mzy2364/MC_GD32/Software/Motor_Control_GD32_Bootloader/README.md

# Motor_Control_GD32_Bootloader

用于GD32电机控制器的bootloader，基于YMODEM协议
