mzy2364/MC_GD32/Software/Application/05_Oneshunt/3_OneShunt_SMO/README.md

# Motor_Control_GD32_ADC_OneShunt_SMO

基于 Motor_Control_GD32 电机开发板的单电阻 FOC 工程
