mzy2364/MC_GD32/Software/Example/12_RS485/README.txt

本例程演示RS485的通讯
需要在5P用户接口插上485扩展板
485波特率9600，定时发送数据，收到数据后会发送收到的数据
