mzy2364/MC_GD32/Software/Application/10_lvgl/04_lvgl_foc/README.md

# 04_lvgl_foc

lvgl foc 综合例程

## 使用说明

上电电机默认运行, 切换到设置界面后电机停止

在主界面短按编码器按钮控制电机起停, 当控制器进入 FAULT 模式后, 短按编码器按钮清除故障

在主界面旋转编码器设置电机的目标转速

在主界面长按编码器按钮切换至设置界面

在设置界面旋转编码器按钮选择设置项, 选择对应的设置项后短按编码器按钮进入单项设置界面

在单项设置界面旋转编码器改变设置参数, 短按编码器按钮切换设置参数的增量

在单项设计界面长按编码器按钮保存并退出设置界面

在设置界面长按编码器按钮切换至监控界面

## 设置界面参数含义

| 参数名 | 单位 | 含义 |
| --- | ---- | --- |
| RES(mR)  | mR | 电机电阻 |
| IND(uH)  | uH | 电机电感 |
| BEMF(mV) | mv | 电机反电动势 |
| POLE | 无 | 电机极对数 |
| RateRPM  | RPM  | 额定转速 |
| OLAMP | 0.1A | 开环电流 |
| OL_LockT | 0.1s | 开环转子锁定时间 |
| OL_RampT | 0.1s | 开环转速爬升时间 |
| OL_HoldT | 0.1s | 开环结束后保持时间 |
| OL_SPD | RPM  | 开环结束转速 |
| SENSOR | 无 | 传感器(0-无感 1-HALL) |
