mzy2364/MC_GD32/FOC参考文档/电机控制标幺化.pdf

986461300@qq.com（原创文档，请勿以任何形式外传；更多资料，搜索闲鱼@人间惆怅客 x）

1 / 17

求道电机控制出品，保留所有版权

# 电机控制标幺化处理解析

李若尘，子渊先生

2 / 17

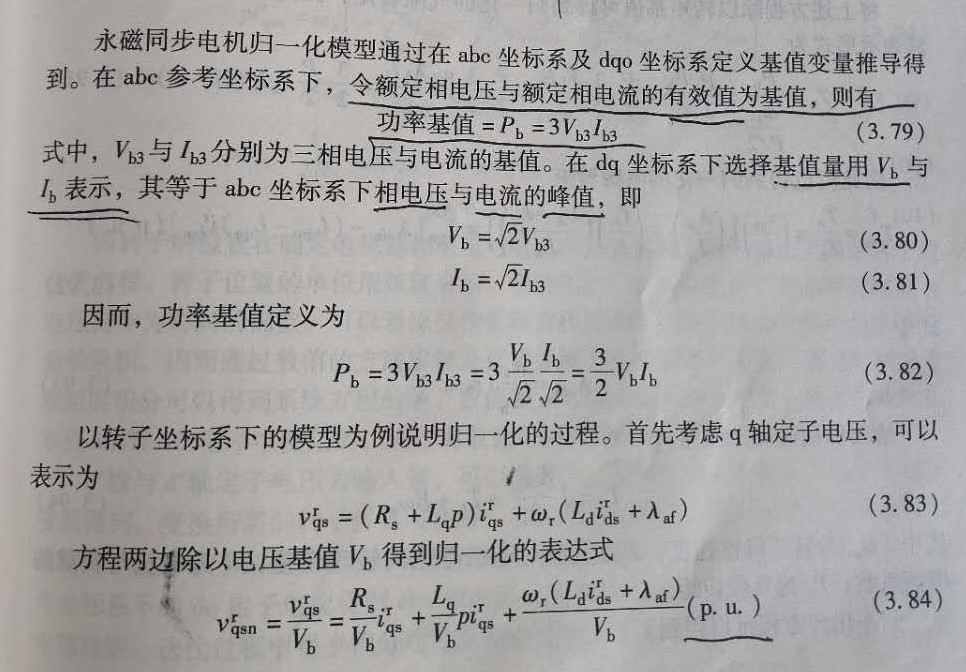
[picture p9: figure]

3 / 17

## 1 电机模型标幺化

4 / 17

### 1.1 电压方程标幺化

将控制系统的参数标幺化可降低运算过程中数据溢出的几率，同时也增加了数据运算的精度。选电压、电 流、频率作为基本基值，则有

/ | 2
/ | /
2
b | b | b | b | b | b
b | b | b | b | b | b | b
b | b
U | Z | U I | W | f
I | L | Z W | | U W
f | | | | π
| | | ψ
| θ | π
ì | | | ì = | =
ï | ï í | í Þ | = | =
ï | ï î | î =

1.1-1

将电机模型等式两边同时除以电压基值 Ub

1/

1

1 | ( | ) ( | )

b

d | s d | d | e | q q d
d d | s d | d | e | q q | U
b | b | b | b
q | q | s q | q | e | d d | r
q | s q | q | e | d d | r | q
b | b | b | b
u | R i | di | w L i di u | R i | L | w L i | L
dt | U | U | dt U | U
di | u | R i | di | w L i u | R i | L | w L i | L
dt | U | U | dt U | U

ψ
ψ

ì ì
= | + | − | ï | = | + | − ï
ï | ï í | í Þ
ï | ï | +
= | + | + | + | = | + | + ï | ï î | î

1.1-2

将式 1.1-1 带入式 1.1-2 可分别得到 d 轴 q 轴标幺化模型

/
1 | ( / ) | ( / ) | ( / )
s d | s b | d | s | d | s | d
b | b | b | b | b | b | b | b
d | d b | d | b | d | d | b | d | d | b
d
b | b | b | b | b
e | q q | e | q q | e | q q b b b
b | b | b b b | b b b
R i | R I i | R | i | R i
U | U I | U I I | Z I
di | L I d i | I | L d i | I | L | d i | I
L
dt U | U | dt | Z | dt | L W | dt
w L i | w L i | w L i W L I
U | U | W L I | W L I

ì
ï | = | = | =
ï
ï
ï
í | = | = | =
ï
ï
ï | = | = ïî

1.1-3

1 | ( / ) | ( / ) | ( / )
( | )
s q | q | q s b | s
b | b | b | b | b
q | q b | q | b | q | q | b | q | q | b
q
b | b | b | b | b
e | d d | r | b b b | e | d d | e | r | e | d d | e | r
b | b | b b b | b | b | b b b | b | b
R i | i | i R I | R
U | U I | Z I
di | L I d i | I | L d i | I | L | d i | I
L
dt U | U | dt | Z | dt | L W | dt
w L i | W L I w L i | w | w L i | w
U | U | W L I | W | W L I | W
ψ | ψ | ψ
| | | ψ | | | | ψ

ì
ï | = | =
ï
ï
ï
í | = | = | =
ï
ï | +
ï | = | + | = | +
ïî

1.1-4

( / )

( / )

d | s | d | d | d | b | e | q q
b | b | b | b | b | b b b
q | q | q | q | b s | e | d d | e | r
b | b | b | b | b | b b b | b | b
u | R i | L | d i | I | w L i
U | Z I | L W | dt | W L I
u | i | L | d i | I R | w L i | w
U | Z I | L W | dt | W L I | W

ψ
ψ

ì
ï | = | + | −
ï
í
ï
= | + | + | + ï
î

1.1-5

以标幺化的变量表示，那么有

*
* | * * | * | * * *

*
* | * * | * | * * * | * | *

1

1

d
d | s d | d | e | q q
b

q
q | s q | q | e | d d | e | r
b

di
u | R i | L | w L i
W | dt

di
u | R i | L | w L i | w
W | dt

ψ

ì
ï = | + | −
ï
í
ï
= | + | + | + ï
î

1.1-6

5 / 17

### 1.2 采样时间标幺化

式 1.1-6 可化为

*
*
* | * * | * | * * * | | | * | * * | * | * * *

*

* | *
* | * * | * | * * * | * | * | * | * * | * | * * * | * | *
*
/ (1/ | )
/ (1/ | )

d
d
d | s d | d | e q q | | | d | s d | d | e q q
b
q | q
q | s q | q | e d d | e | r | q | s q | q | e d d | e | r
b
di | di u | R i | L | w L i | u | R i | L | w L i dt | W | dt
di | | | | | | | | | | di
u | R i | L | w L i | w | u | R i | L | w L i | w
dt | W | dt
ψ | ψ
ì | ì
ï = | + | − | ï = | + | − ï | ï í | í Þ
ï | ï = | + | + | + | = | + | + | + ï | ïî î

1.2-1

对比可知时间可以 1/(2*pi*fb)为基值进行标幺化。完全标幺化之后，标幺模型和有名值模型在形式上可以 做到统一

*
* | * * | * | * * *
*

*
* | * * | * | * | * * | *
*
( | ) | ( | )
d | d
d | s d | d | e | q q | d | s d | d | e q q
q | q
q | s q | q | e | d d | r | q | s q | q | e | d d | r
di | di
u | R i | L | w L i | u | R i | L | w L i
dt | dt
di | di
u | R i | L | w L i | u | R i | L | w L i
dt | dt ψ | ψ
ì | | | | | | | | | | ì
ï = | + | − | = | + | − ï
ï | ï í | í Û
ï | ï = | + | + | + | = | + | + | + ï | ï î | î

1.2-2

那这意味着观测器本身相关的代码都不用改，只改变电机参数、系数以及电流电压等变量即可。在实际工 程中因为两套参数范围不太一样，故采用 Q 格式定点格式数据的时候代码并不能复用。 以下讨论基于标幺值模型，变量不再以‘*’区分。由式 1.4-8 可得微分方程

1
( | )

1
( | ( | ))

d
d | s d | e | q q
d

q
q | s q | e | d d | r
q

di
u | R i | w L i
dt | L
di
u | R i | w L i
dt | L

ψ

ì
= | − | + ï
ï
í
ï | = | − | − | + ï
î

1.2-3

令 dt 为采样周期 Ts，则每一拍的电流增量为

( | )
( | ( | ))

s
d | d | s d | e | q q
d

s
q | q | s q | e | d d | r
q

T
di | u | R i | w L i
L
T
di | u | R i | w L i
L

ψ

ì
= | − | + ï
ï
í
ï | = | − | − | + ï
î

1.2-4

6 / 17

### 1.3 磁链的峰值和有效值

电机模型具有统一的形式

*
* | * * | * | * * *
*

*
* | * * | * | * | * * | *
*
( | ) | ( | )
d | d
d | s d | d | e | q q | d | s d | d | e | q q
q | q
q | s q | q | e | d d | r | q | s q | q | e | d d | r
di | di
u | R i | L | w L i | u | R i | L | w L i
dt | dt
di | di
u | R i | L | w L i | u | R i | L | w L i
dt | dt ψ | ψ
ì | | | | | | | | | | ì
ï = | + | − | = | + | − ï
ï | ï í | í Û
ï | ï = | + | + | + | = | + | + | + ï | ï î | î

1.3-1

标幺模型中电机参数 R、Ld、Lq、phi 使用标幺值，相应的输入电压、电流和角速度也使用标幺值，整个 系统使用同一套基值。相应的，如果参数都取有名值，那么就是使用有名值模型。
Y 型接法电机线电流和相电流是一样的，但是线电压和相电压则相差一个 sqrt(3)。很明显，在 dq 系模型 中 udq 都是指相电压，在实现电机模型的时候一定要使用‘相值’。电流环中输出电压 ud 和 uq 具有线值的 含义，因此在实现有名值模型的时候要除以 sqrt(3)转换成相值。
本来在 dq 系中电压和电流稳定时都是直流量，没有峰值和有效值的概念。但是由于电压和电流都是由 alpha-beta 系中正弦量转换而来的，取决于克拉克变换系数，常令 dq 系中矢量幅值等于 alpha-beta 系中电信号 的峰值或者有效值，于是 dq 系也有了区分。
从公式来看，还不是电压和电流统一使用有效值或者峰值就可以，还要考虑永磁链的处理。永磁链的计算 公式为
1 | 3
2 | 2 r | ph kV
f

ψ
π
= | × | ×
1.3-2

K 值取 2/3 或者 sqrt(2)/3，phi_r 的值是不一样的，实际上还是 2*pi*f*phi_r 这个反电势是取峰值还是有效 值的区别。K = sqrt(2)/3 时，phi_r 取的是‘有效值’。

7 / 17

### 1.4 汇川对应代码

### 1.4.1 电阻标幺

取电机额定电压对应相值作为电压基值，以电机额定电流（线值和相值一样）作为电流基值，电机定子电 阻标幺化处理如下
m_UData = ((Ulong)gMotorExtInfo.RsPm * (Ulong)gMotorInfo.Current)/gMotorInfo.Votage; gMotorExtPer.Rpm = ((Ulong)m_UData * 18597)>>14;
代码中电阻单位为毫欧、电流单位为 0.01A、电压单位为 1V，故
14 | 14
18597 | . | 18597 | 1000 | 100
2 | . | 2 | 3

s

| | | b

b
pu
RsPm gMotorInfo Current | I
R
| gMotorInfoVota

R
| ge | | U
- | × | · ×
=
× | ×
× | ×
×

=
1.4-1

整理得

5
16 | 16
14 | /
18597 10 | 2
2 | 3 | /

2

s | s
spu
b b

u
b

p
b
R | R
R
U

R
I | I U

×
= | = | · | = | ×
×
- 1.4-2

电机标幺值具有 Q16 格式，因为一般情况下 Un/In 还是比定子电阻大很多，所以不用考虑溢出的问题。比 如电机 Rs = 1.500、Un = 17、In = 1.50。

8 / 17

### 1.4.2 电感标幺

m_BaseL = ((Ulong)gMotorInfo.Votage * 3678)/gMotorInfo.Current; m_BaseL = ((Ulong)m_BaseL * 5000)/gBasePar.FullFreq01;//Q15 m_Ulong = ((Ulong)gMotorExtInfo.LD <<14) + (m_BaseL >>1); m_Ulong = m_Ulong / m_BaseL;
gMotorExtPer.LD = m_Ulong / 10; // 同步机 d 轴电感 Q13 首先求电感基值
3678 5000 | . | 3678 5000 | 3
_ | =
. | 01 | . | 100 | 100 b
b | b
gMotorInfoVotage | U
m BaseL
gBasePar FullFreq | gMotorInfo Current | f | I
× | × | ×
- ·

× ×
=
| | | | × | ×

1.4-3

整理得

3678 5000 | 3 2 _ | =3678 | 3 | =3678 | 3
100 100 | 2

b

b

b
b
b | b

U
mB

Z
aseL | L
f I | W

π
π | π
π
× | × | ×
= | · | × | · | × | ·
× | ·

1.4-4

省略代码中四舍五入的处理，电感量单位为 uH，故变量 m_Ulong 满足

14 | 14 | 6 14 | 6 2 | . | 2 | 10 2 | 10 | 13 _ | = | = | 100 2
3678 | 3 | 3678 | 3 | 3678 | 3

d
dpu | d u
b

p
b
gMotorExtInfo LD | L
m Ulong | L | L
π | π | π L | L
× | × × | ×
= | = | ×
× | · | × | · | ×

1.4-5

最后除以 10

13
13 _ | 100
10 | 10
| 2
10 2

dpu
dpu

m Ulong gMotorExtPer LD

L
L

×
= | × | ×

×
= | =

1.4-6

电感经过上述代码处理之后，除了 Q13 格式外还有个系数 10，比较突兀，可能是处理有问题。直观上看 一下电感标幺，令 Un = 17、In = 1.50、fn = 220Hz、Ld = 600uH，电感标幺值数值上还是比较小的

4 0.0082
2

17
= | = | 6 10 2 | 220 1.5

0.008

0.07
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
f | L
L

L
I
H
π | π

−
·
=

ì
ï | = | ×
í | × | × | Þ | = | =
ï
î

1.4-7

9 / 17

变量 gMotorExtPer.LD 具有 Q13 格式，令 Ld、Lb 为带 SI 单位的有名值，那么有

13
. | 2 () d

b

gMotorExtPer LD

L
SI
L

= ×
1.4-8

两边同乘以 10，于是

13 | _
10 | . | 10 | 2=
_

d

b

L | m Ulong gMotorExtPer LD
L | m BaseL
× | = | × | ×
1.4-9

将变量 m_Ulong 带入式 1.4-9，并省略四舍五入的计算，那么有

13 | 14 ( | . | 14 | ( _ | 1) | . 10 | 2
_ | _

)
2 = | = d

b

gMotorExtInfo LD | m BaseL | gMotorExtInfo LD
m BaseL | m BaseL

L
L
<< | + | >>
× | × | ×
1.4-10

变量 gMotorExtPer.LD 的单位应该是 uH，于是可化为

6 | 6
1 | 14

6
3
. | /1 | 10 10 | 2 | 5
_

1
_
10 2 = | = d | 0
b | b m BaseL | m BaseL
L | gMotorExtIn | D
L

fo L
L

·
× | × | × | Þ ×

1.4-11

将 Lb 展开并整理，得

6 | 6
_
5

10 10
=
| 5 2
b | b
b | b

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
1.4-12

其中有

3
10

=

=
0
. | 01
10

=
0

b

b

b

gMotorInfoVotage

gMotorInfo Current

gBasePar FullFreq

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
1.4-13

将式 1.4-13 带入式 1.4-12 得

6
10 100 100
=
2
_
5 | . | 01 | . 3

gMotorInfoVotage m BaseL
π | gBasePar FullFreq | gMotorInfo Current ·

×
×

1.4-14

整理常数项

3678 | .
_ | =
. | 01 | .
9. | 00 99 | 50 | gMotorInfoVotage m BaseL
gBasePar FullFreq | gMotorInfo Current
× | ×
×
·

1.4-15

这里也有个 10 的系数。
于是，从正反两面进行推导，电感标幺化的结果都是理论结果的 10 倍，后续电流模型的推导可以证明这 个 10 倍的系数不应该存在。（可能是因为电感的单位是 10uH）

10 / 17

### 1.4.3 磁链标幺

在 dq 坐标系，永磁链产生的反电势为（相电压）

1.4-16

令此时三相电压信号峰峰值为 Vlpp，则相电压峰值为

/ 2 / 3 V | V ph | lpp =
1.4-17

相电压经过克氏变换，在两相静止坐标系内电压信号峰值变为

3
2
V | kV m | ph =

1.4-18

由于 park 变换不改变矢量长度，故式 1.4-18 与式 1.4-16 相等，于是

3 | 1 | 3 2
2 | 2 | 2 ph | r | r | ph kV | f | k V
f

π ψ ψ
π
= | · | Þ | = | × | ×
1.4-19

磁链基值和电压基值关系密切

2
2

b
b | b | b | b
b

U
U f
f
ψ | π ψ
π
= | Þ | = | ·
1.4-20

于是磁链的标幺化可以由反电势标幺化实现，以频率基值对应的反电势除以电压基值即可，辨识反电势时 将频率做相应的转换即可

| 2
/
| 2
b | r | r
emfb | b
b | b | b

f
V U
f
πψ | ψ
π ψ | ψ

·
| | | | | | | | | | | | | | | | = | | =
| | | | | | | | | | | | | | | | | ·

1.4-21

处理磁链标幺化的代码如下
m_Ulong = ((long)gMotorExtInfo.BemfVolt <<12) / (gMotorInfo.Votage *10); //Q12
gMotorExtPer.FluxRotor = (m_Ulong << 15) / gMotorInfo.FreqPer; | //Q12
其中变量 gMotorExtInfo.BemfVolt 为 0.1V 精度的额定频率对应的反电势线电压有效值，这个电压应该是在 对拖时可以用电压表、示波器等量得到的实实在在的线电压。
取克拉克变换系数 k= sqrt(2)/3，由式 1.4-19 可得反电势对应的线电压有效值，满足
3 | 3 | 2 | 1 | 3 2 | 3 2
2 | 2 | 3 | 2 | 2 ph | ph | ph | r | ph | r kV | V | V | f | V | f = × | = | = | · | Þ | = | × | · π ψ | π ψ

1.4-22

以电机额定电压进行标幺化

12 | 12 | 12 . | 2 | 2 | 2 _ | 10
10 | .
| | | | | | | | | | | | | | | | | | | 2
10

2
3
3 | n | r | r
| | | | | | | | | | | | | | | | | | b | | | | b

n

gEstBemf BemfVolt m Ulong
gMotorInfoVotage | U U
π | ψ | π | ψ f | f ×
= | = | ×
× | ×
× | · | = | ·
1.4-23

再由额定频率转换为频率基值

15 | 15
12 | 12 | 12
15
2 | 2 . | 2
2

2
2
/

2

2
2
n | r | r n | b
b | b | b n | b

r

f | f | f gMotorExtPer FluxRotor
gMotorInfo FreqPer | U | U | U ff
| π ψ | π ψ | π ψ
= | × | × | ×
×
= | =

1.4-24

将电压基值展开，得到 Q12 格式的磁链标幺值

2 | 2 12 | 12 | 12
2
. | 2 | 2 | 2 b | b

b

r | r
b | b | b

r

f | f gMotorExtPer FluxRotor
U | f
π ψ | π ψ | ψ
| π ψ | ψ
= | × | × | × = | =
1.4-25

值得一提的是，如此处理得到的永磁链具有‘相值’的涵义，正好和电压、电流信号一致。

2 V | f emf | r = | · πψ

11 / 17

## 2 电流 PI 控制器标幺化

12 / 17

### 2.1 理论推导

电流环 PI 控制器，其输入为电流偏差，输出为控制电压，易知其传递函数为

d | i
p
d
u | k k
i | s
= | +
Δ

2.1-1

电压和电流已经标幺化的基值了，式 2.1-1 可化为

/ | /
/ | /
d | b | b | d | b | b | b | i pu
p
d | b | b | d | b | b | pu | b
u | u u | u | u | u | u | k u
k
i | i i | i | i | i | i | i | s
| ·
= | · | = | · | = | +
Δ | · | Δ | | | Δ

2.1-2

进一步地

1
( | ) pu | b | i | b | b
p | p | i
pu | b | b | b
u | i | k | i | i k | k | k
i | u | s | u | u | s
= | + | = | +
Δ

2.1-3

经过标幺化之后，PI 参数变为

b
pu | p
b

b
ipu | i
b

i
k | k
u
i
k | k
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
2.1-4

如果 PI 控制器是规范使用自动控制原理设计的，那么 Kp 和 Ki 和电机电阻和电感参数有关，标幺化处理之 后可以电阻取其标幺值，但电感并非如此。

13 / 17

### 2.2 汇川对应代码

SVPWM 线性区输出线电压峰值为

3
2
dc v | U =α

2.2-1

调制系数 alpha 可以取到 2/sqrt(3)=1.15，对应的线电压有效值为 Udc/sqrt(2)。软件中母线电压变量单位为 0.1V，需要转换单位；最大输出电压以电机额定电压为基值进行标幺化，以 Q12/Q24 格式表示：

12

/10 / *
2

dc
max | mot

U
v | v | Q =

2.2-2

data1 = ((long)gUDC.uDCFilter | * 2316L)>>15; | // Udc/sqrt(2)/10
pm_maxout_vol = (data1<<12)/gMotorInfo.Votage;
maxu = (long)pm_maxout_vol<<12;
minu = -maxu;
电流偏差是以电机额定电流为基值的标幺值，具有 Q12 的格式；pm_integral_d 受[maxu,minu]限制，故积 分量具有 Q24 格式；计算积分增量时有(pm_error_id * pm_ki_d >> 4)，可见积分增益 ki 具有 24+4-12=16 的 格式。由计算积分增量的方式可以看出代码所实现的是并联结构 PI 控制器，同时积分增益中隐含了控制周期 参数，是上一节提到的所谓的新积分增益。
pm_error_id = pm_ref_id - gIMTQ12.M;
pm_integral_d = pm_integral_d + (pm_error_id * pm_ki_d >> 4); //Q24,28-4 pm_integral_d = __IQsat(pm_integral_d, maxu, minu);
计算比例部分，因为比例部分可以和 Q24 格式的积分部分相加，故可以认为比例增益是具有 24-12=Q12 格式的数据。
data1 = (pm_integral_d + pm_error_id * pm_kp_d)>>12; data1 = __IQsat(data1,pm_maxout_vol,-pm_maxout_vol); pm_ud = data1;
由猫不和狗比原理可知，电压 pm_ud 也是以电机额定电压（线电压）为基值的 Q12 格式数据，不带小数 点！并且 ud 本身也带有‘线值’的内涵。给 ACR 控制器的输出赋予“线电压有效值”的涵义具有现实的好处， 因为评价输出电压的大小更多的是和电机额定电压进行比较，而后者最常见的形式就是线电压有效值。从本质 上来讲，ud 和 uq 应该是 d 相和 q 相的相电压。
最后再强调一遍，当前软件中电流环 PI 控制器比例增益 Kp 为 Q12 格式数据，积分增益 Ki 是 Q16 格式的 “新”积分增益。
以浮点类型有名值实现 PI 控制，那么有
1 | 1 ( | ) k | k | p | k | i s | k | k | p v | i k | i k T | v | i | k = Δ · | + Δ · | + | − Δ | ·
− | − | 2.2-3

其中，输出 vk 是实际输出电压，delta_i 是实际的电流偏差。当对数据进行标幺化并用 Q 格式表示时，令 输出电压和电流偏差满足

24 | 24
12 | 12
2 | 2
2 | 2
k | k
pu
b | mot
k | k
pu
b | mot
v | v
v
v | v
i | i
i
i | i
= | × | = | ×
Δ | Δ Δ | = | × | = | ×

2.2-4

计算积分增量时得到的是以电机额定电压为基值的 Q24 格式表示的原始积分增量，即满足

4 | 24
12 | 28
/ 2 | 2
2 | 2 pu | pu | ipu | k | k | i s
mot | ipu
mot | mot
| k | i s

x
x | i | k | i | i k T
v | k
i | v x | i k T
Δ | ü
Δ | = Δ | · | = | × | ï | Δ | Δ · ý Þ | × | · | = | ×
ï Δ = Δ · | þ

2.2-5

可推出在标幺值系统下，积分增益满足

14 / 17

16 ( | ) | 2 mot
i u | s
mot
p | i

i
k
v
= | · | × kT

2.2-6

可以看到，除了 Q16 格式化以外，k_ipu 还隐含了电机的额定电流和额定电压。 同样地，计算比例控制量时满足

12 | 12
12 | 12
/ 2 | 2
/ 2 | 2 pu | pu | ppu | k | p
mot | pu | ppu

mot
k p

y
y | i | k | ik
v | i | k
v
y i k

ü
= Δ | · | = | × | ï | Δ·
ý Þ Δ | · | = | ×
ï = Δ · | þ

2.2-7

可推出采用标幺值时，比例增益满足

12 2
mot
pp
mot

u p

i
k
v
= | · | × k

2.2-8

综上所述，使用标幺化系统实现 PI 控制时，PI 参数也隐含地经历了标幺化，而不仅仅是执行了 Q 格式化 那么简单。

12

16

2

( | ) | 2
| mot
ppu
| mot

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
= | · | × ï
ï
í
ï | = | · | × ï
î

2.2-9

上式错误!未找到引用源。可以看作是对电阻进行了标幺化处理，处理之后就不会出现 RL 数值较大时 PI 参数数值上特别大的情况。

15 / 17

## 3 锁相环标幺化

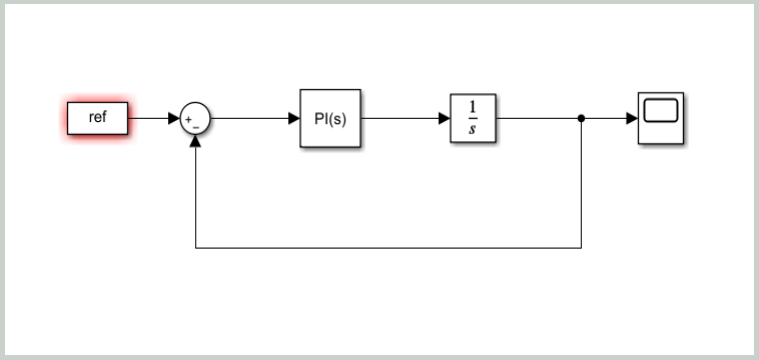
[picture p10: figure]

图 2.2-1 PLL 框图
锁相环主要由一个 PI 控制器和一个积分器构成，输出转速和角度两个量，所以标幺化需要分两个阶段进 行处理。

16 / 17

### 3.1 PI 标幺

锁相环 PI 输入为角度偏差，输出为角速度，其传递函数为

i
p
w | k
k
θ | s
= | +
Δ

3.1-1

角速度和角度标幺基值为

2 b | b

b

w | f π
θ | π

ì =
í
î =

3.1-2

于是，式 3.1-3 可化为

/ | 2 | 2
/
b | b | b | i pu | pu
b | p
b | b | pu | pu
w | w w | w | f | k w | w
f | k
s

π
θ | θ θ θ | θ | π | θ
= | · | = | · | = | · | = | +
Δ | Δ | Δ | Δ

3.1-4

进一步地

1 | 1 | 1 2
2 | 2
pu | pu i
b | p | p | i
pu | pu | b | b
w | w k
f | k | k | k
θ | θ s | f | f | s
- | = | + | Þ | = | +
Δ | Δ

3.1-5

经过标幺化之后，PI 参数变为

1
2
1
2
pu | p
b
ipu | i
b
k | k
f
k | k
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
3.1-6

也就是说，如果想要 PI 输出为标幺化的角速度，那么 PI 参数就要按照式 3.1-7 进行处理，尽管形式上看起 来十分怪异。

17 / 17

### 3.2 积分标幺

对角速度积分得到角度，其传递函数为

1
w s

θ
=

3.2-1

角速度和角度标幺基值为

2 b | b

b

w | f π
θ | π

ì =
í
î =

3.2-2

于是，式 3.2-3 可化为

/ | 1
/
b | b | b pu
w w w | w | w | s b | b | pu | b
θ θ θ | θ θ
- | = | · | =
3.2-4

进一步地

1 | 1 | 1 | 1 2
2
pu | pu b | b | b
b
pu | b | pu | b
w | f | f
w | w | s | w | s | s | s
θ | θ θ | π
θ | π
- | = Þ | = | · = | · = | ·
3.2-5

标幺化之后，积分增益由 1 变为 2*fb。
实践表明，如果不采用上述方式进行标幺化，那么锁相环 PLL 压根无法稳定，也从侧面证明了上述标幺化 处理过程的正确性。
