mzy2364/MC_GD32/PIC/MC_GD32_02.png

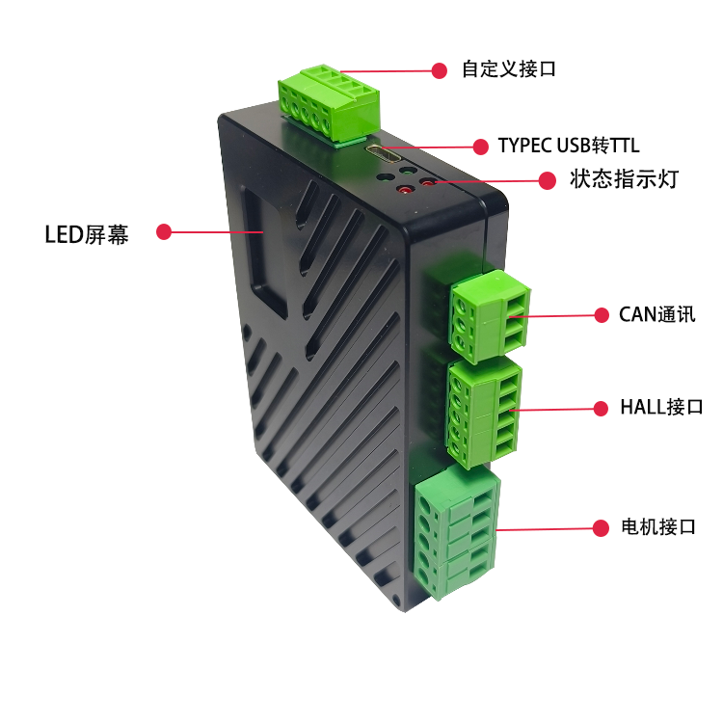
PIC/MC_GD32_02.png
