mzy2364/MC_GD32/PIC/MC_GD32_03.png

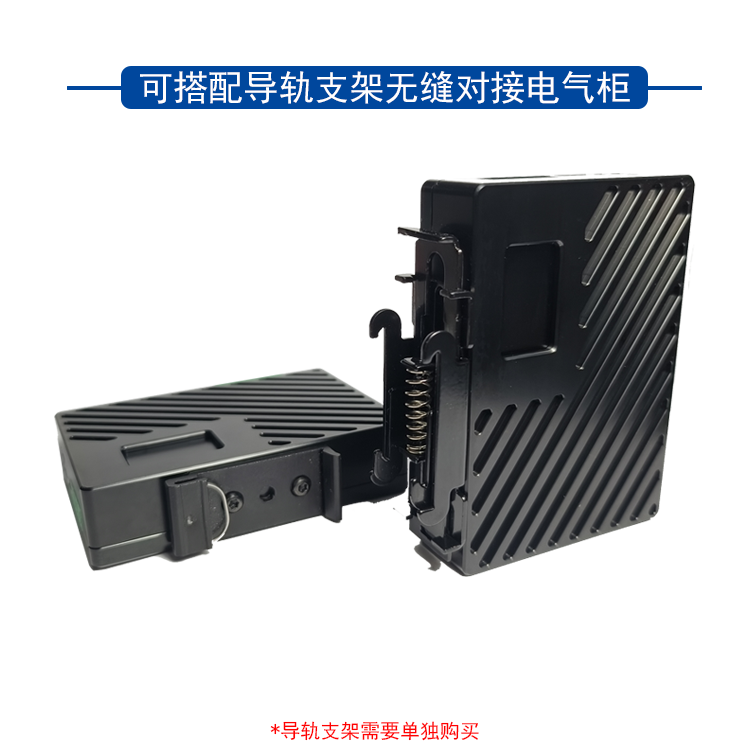
PIC/MC_GD32_03.png
