mzy2364/MC_GD32/Software/Example/9_pwmadc/RigolDS0.png

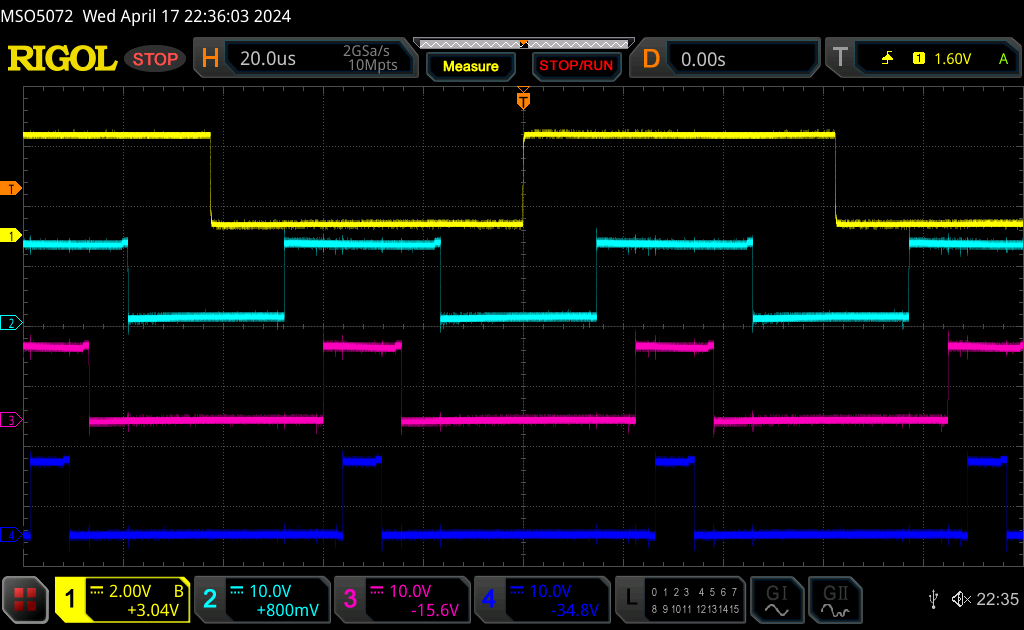
Software/Example/9_pwmadc/RigolDS0.png
