mzy2364/MC_GD32/Software/Example/8_adc/Sunlord Products Characteristic Vout max_Curcuit0_SDNT1608X103F3950FTF.xlsx

Temperature (℃) | Vout max (V) | Vout typ (V) | Vout min (V)
-40 | 3.216616633 | 3.211906695 | 3.206938431
-39 | 3.210777577 | 3.205810467 | 3.200575415
-38 | 3.204590503 | 3.199356412 | 3.193844716
-37 | 3.198039421 | 3.192528494 | 3.186730276
-36 | 3.19110798 | 3.185310348 | 3.179215745
-35 | 3.183779503 | 3.177685312 | 3.171284508
-34 | 3.176037008 | 3.169636462 | 3.162919729
-33 | 3.167863248 | 3.161146643 | 3.15410438
-32 | 3.159240747 | 3.152198516 | 3.144821296
-31 | 3.150151844 | 3.1427746 | 3.135053211
-30 | 3.140578741 | 3.132857323 | 3.124782824
-29 | 3.130503552 | 3.122429079 | 3.113992846
-28 | 3.119908365 | 3.111472285 | 3.102666065
-27 | 3.108775299 | 3.099969446 | 3.090785415
-26 | 3.097086573 | 3.087903222 | 3.078334043
-25 | 3.084824581 | 3.075256506 | 3.065295388
-24 | 3.071971961 | 3.062012499 | 3.051653256
-23 | 3.058511681 | 3.048154793 | 3.037391907
-22 | 3.044427127 | 3.033667456 | 3.022496142
-21 | 3.029702185 | 3.018535126 | 3.00695139
-20 | 3.014321343 | 3.002743101 | 2.990743806
-19 | 2.998269782 | 2.986277439 | 2.973860364
-18 | 2.981533481 | 2.969125055 | 2.956288956
-17 | 2.964099315 | 2.951273822 | 2.938018491
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
