mzy2364/MC_GD32/Software/Application/05_Oneshunt/0_TestFile/1_PWM_SHIFT/三相下管信号不移相.png

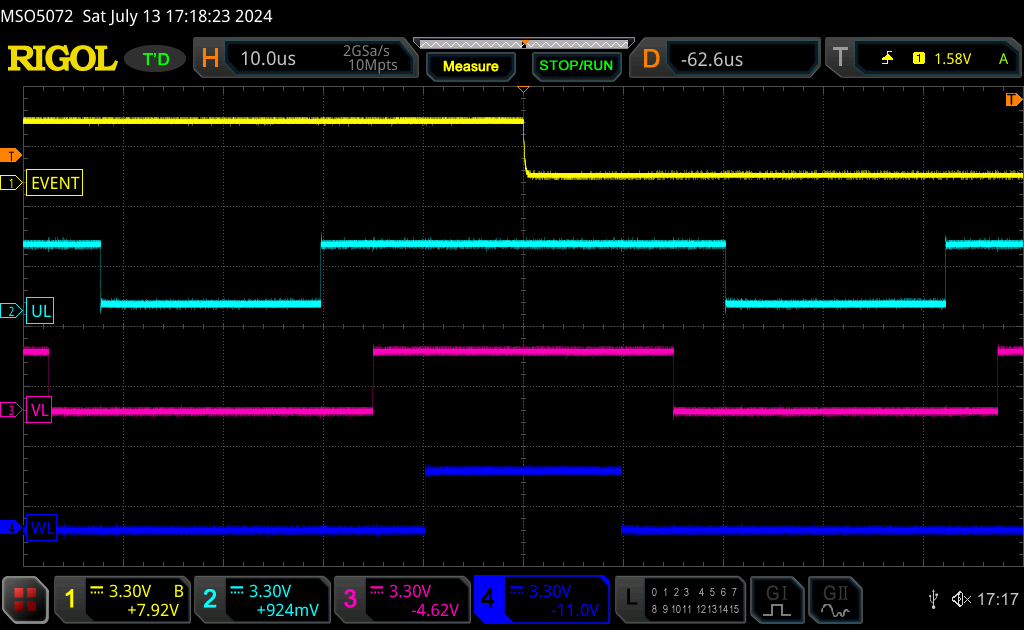
Software/Application/05_Oneshunt/0_TestFile/1_PWM_SHIFT/三相下管信号不移相.png
