mzy2364/MC_GD32/Software/Application/05_Oneshunt/0_TestFile/2_ADC_DOUBLE_SAMPLE/三相下管信号和ADC采样完成信号.png

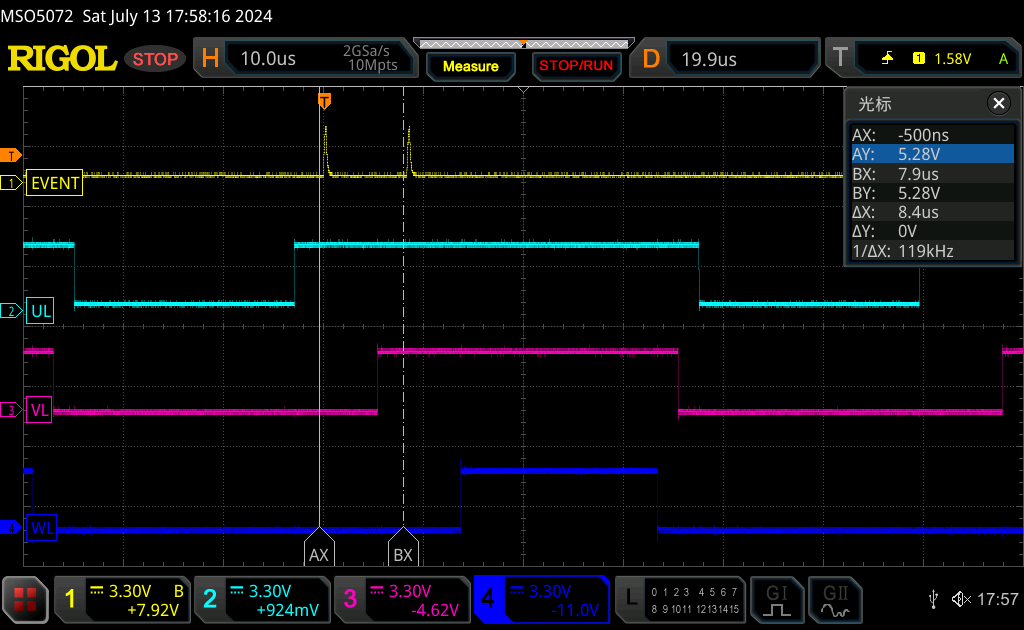
Software/Application/05_Oneshunt/0_TestFile/2_ADC_DOUBLE_SAMPLE/三相下管信号和ADC采样完成信号.png
