mzy2364/MC_GD32/Software/Application/05_Oneshunt/0_TestFile/3_OneShunt_SMO/三相下管和IDC.png

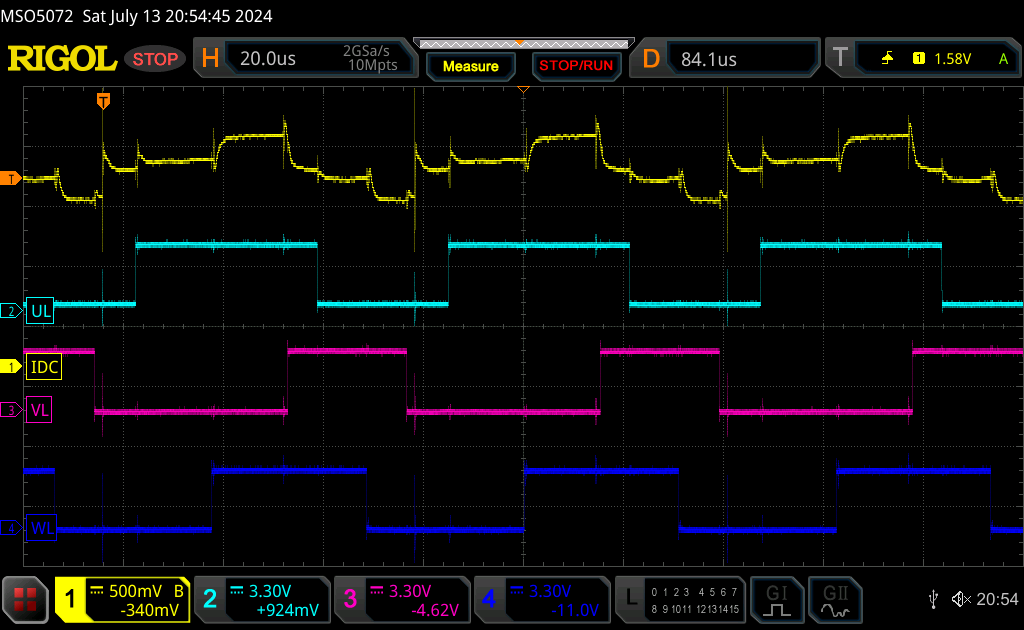
Software/Application/05_Oneshunt/0_TestFile/3_OneShunt_SMO/三相下管和IDC.png
