mzy2364/MC_GD32/Hardware/Motor_Control_GD32_V4_2.pdf

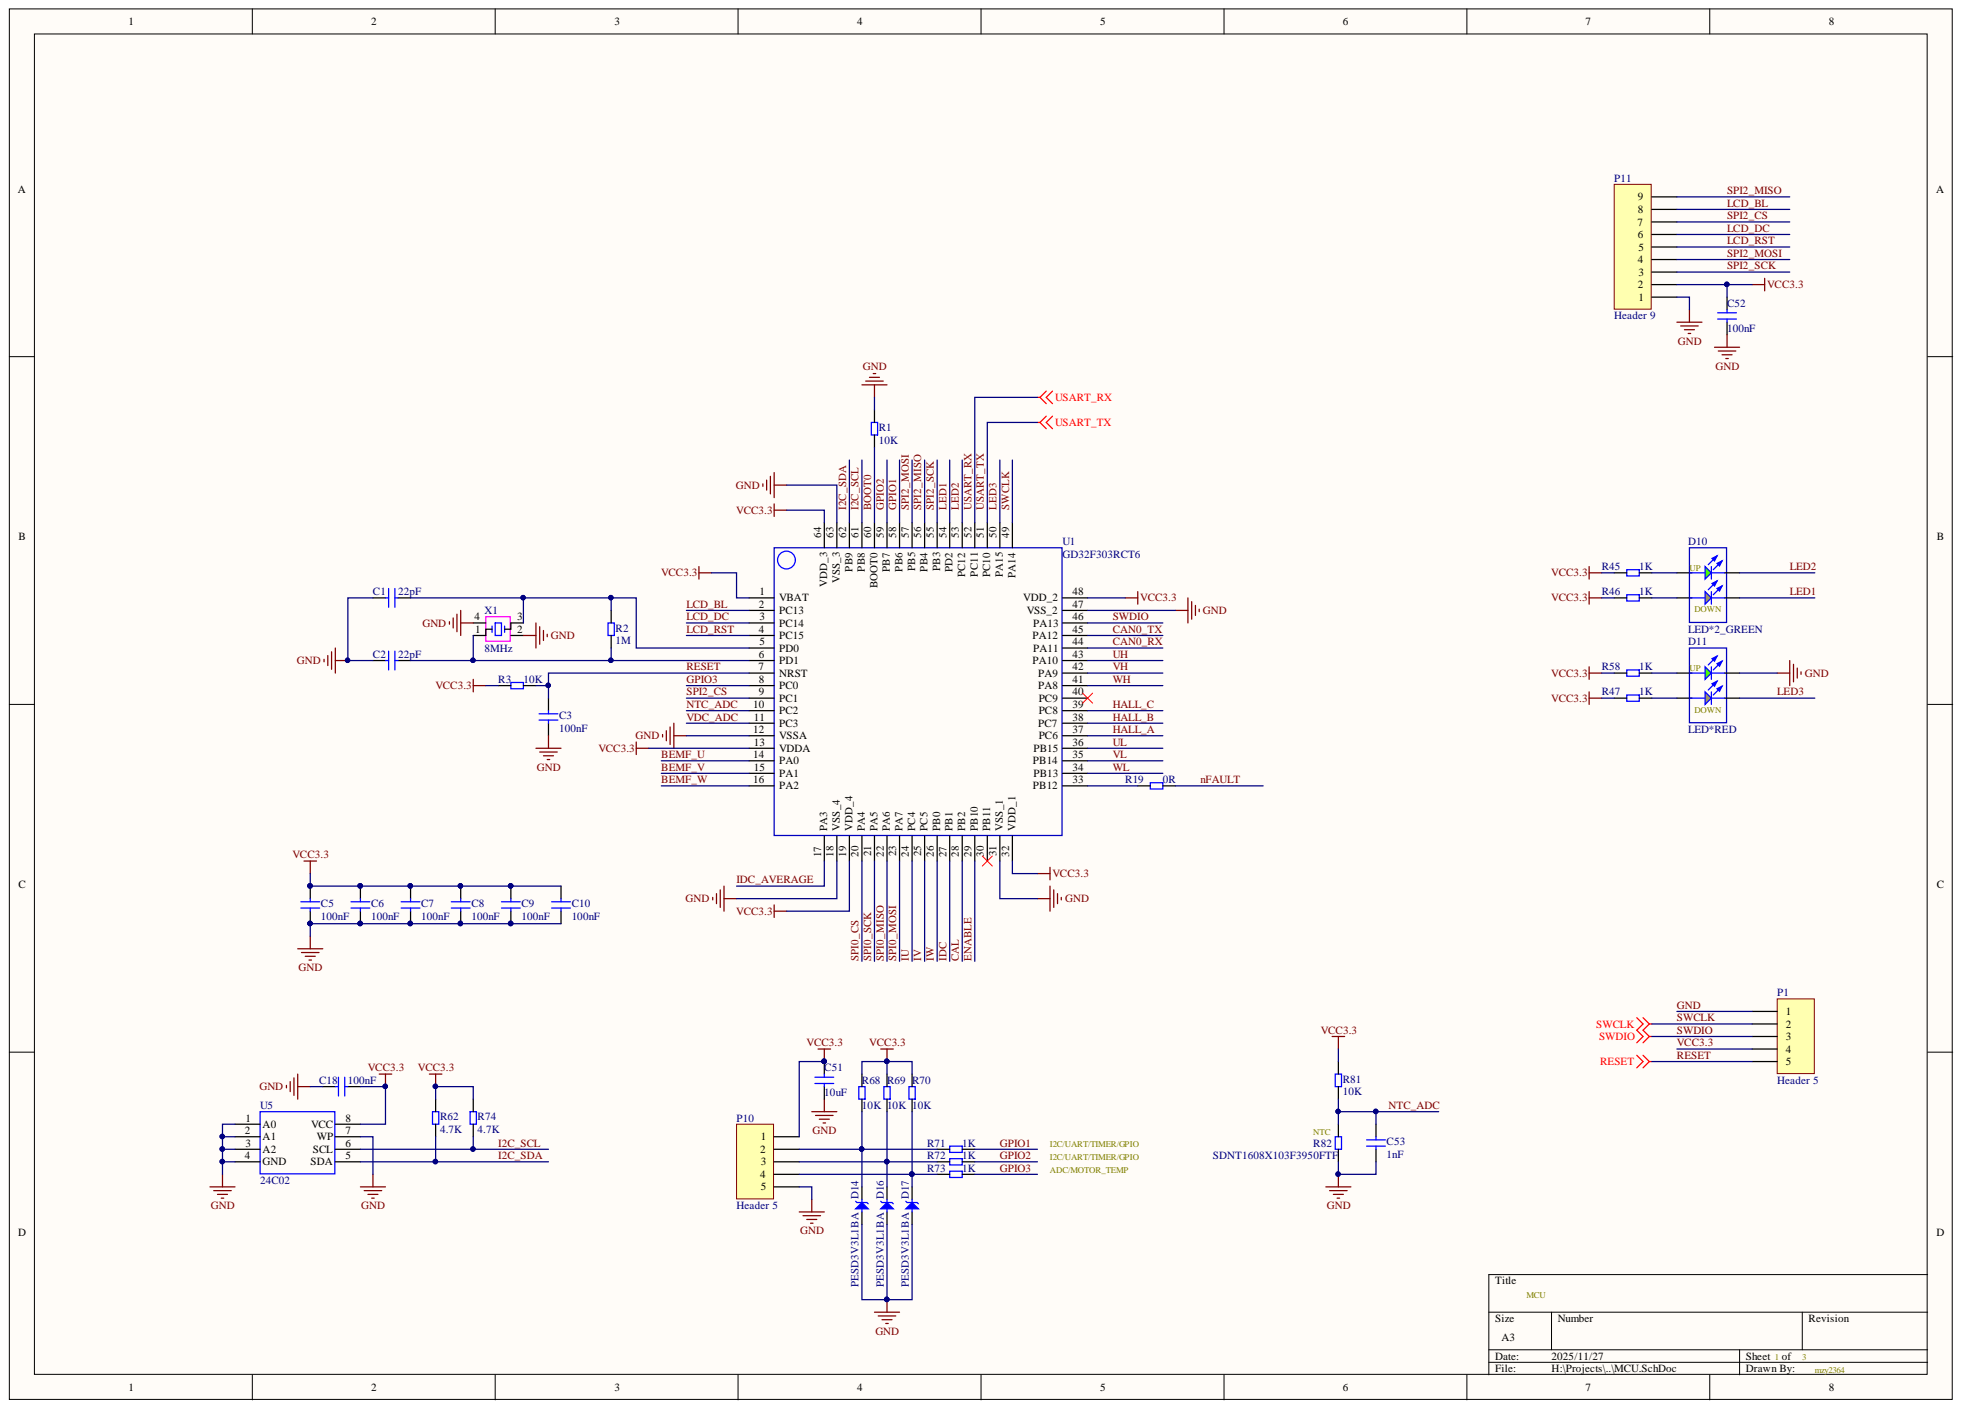
[picture p64: page 1]

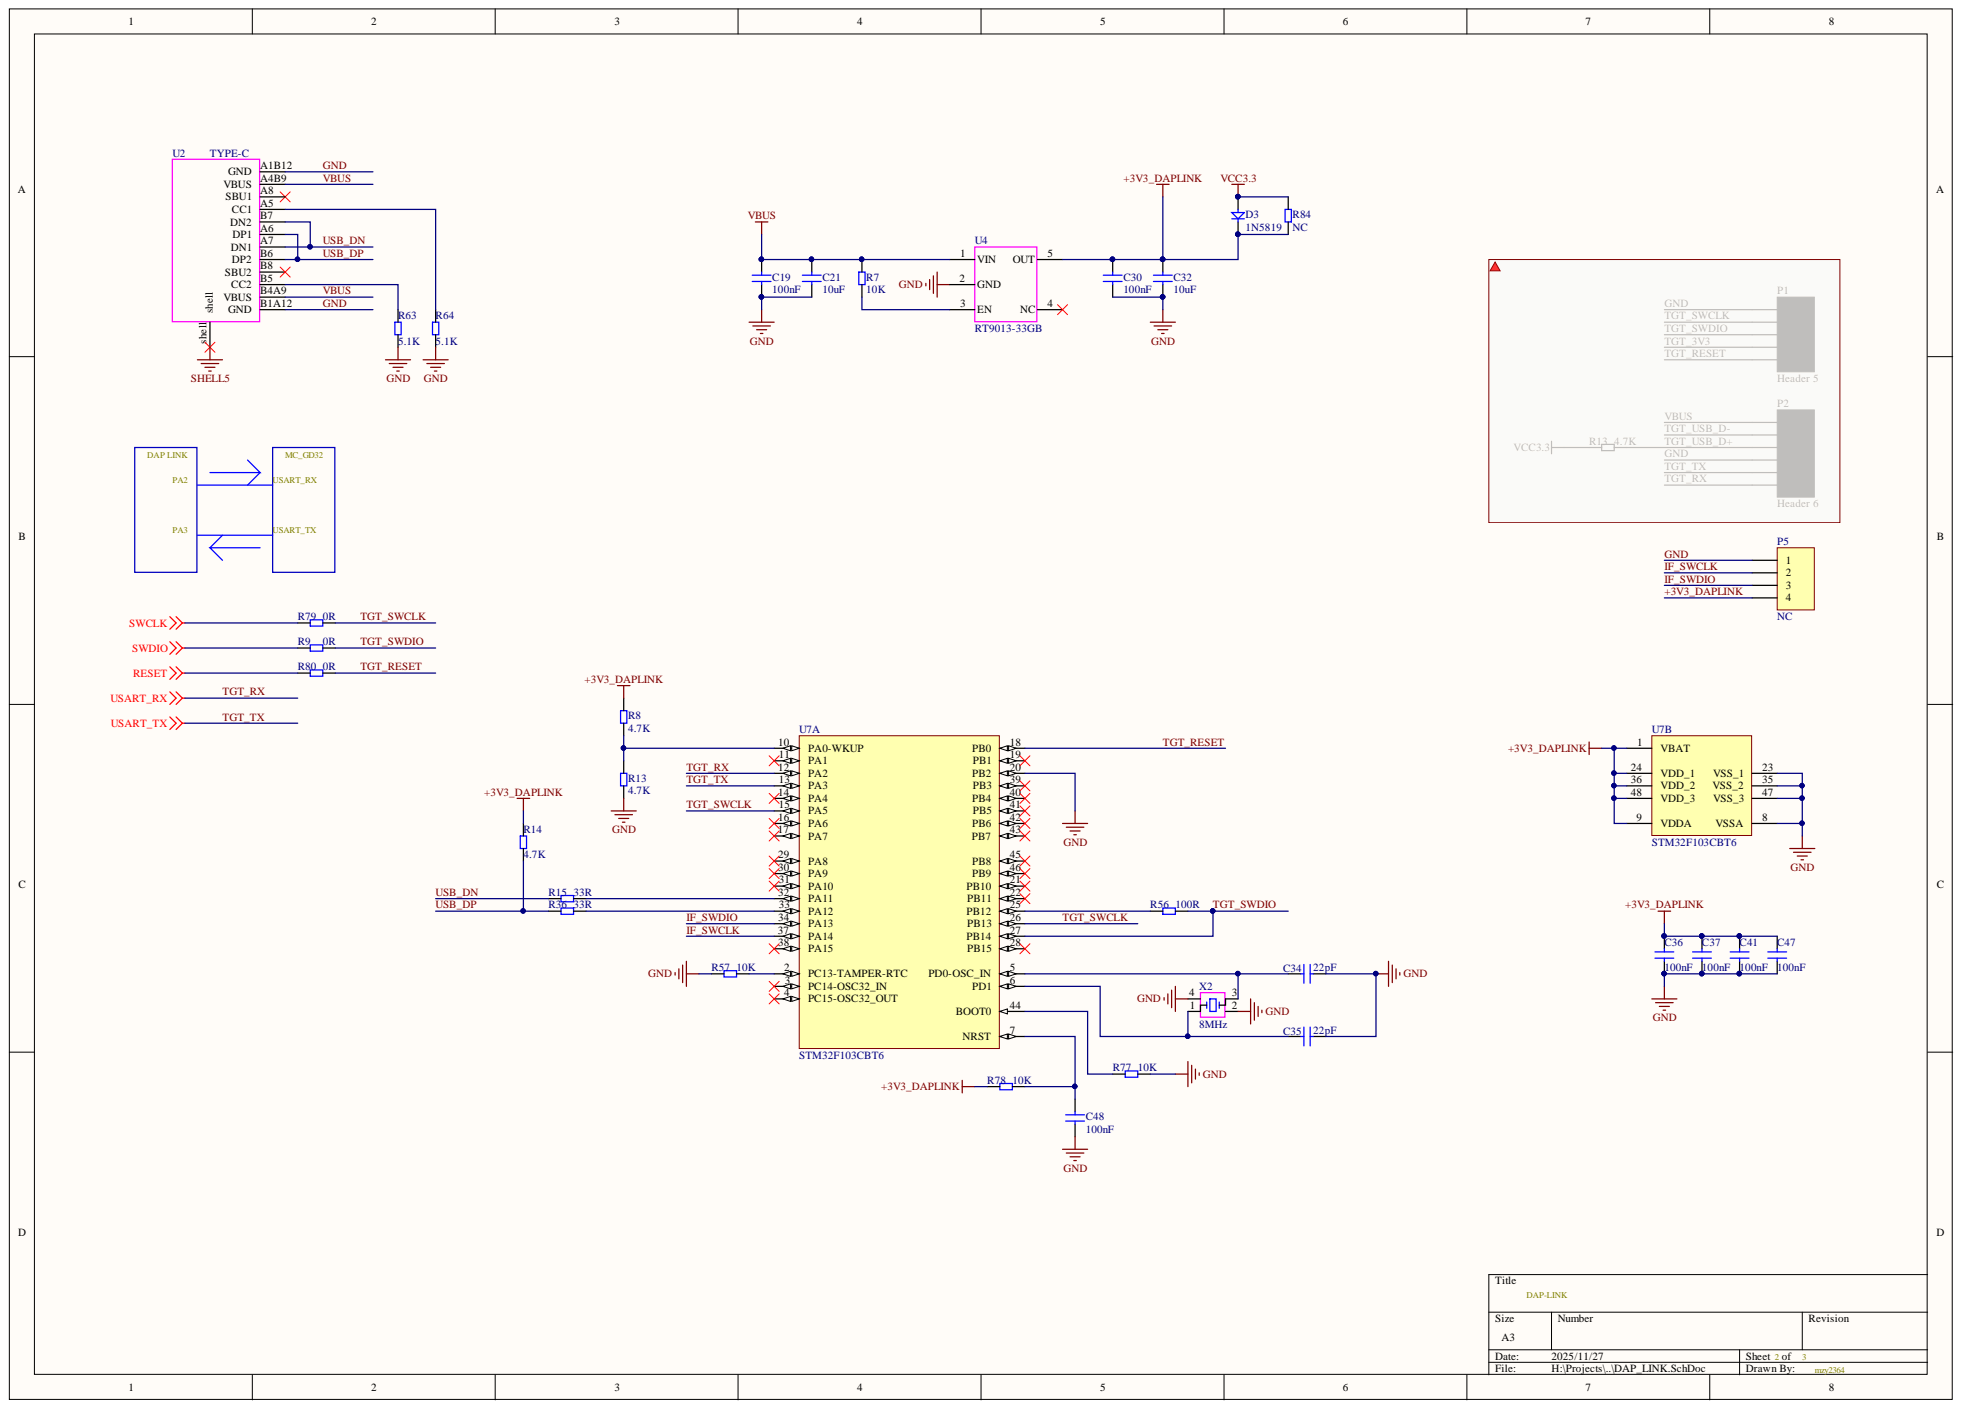
[picture p65: page 2]

GND 2 | C30 | P1

VBUS GND

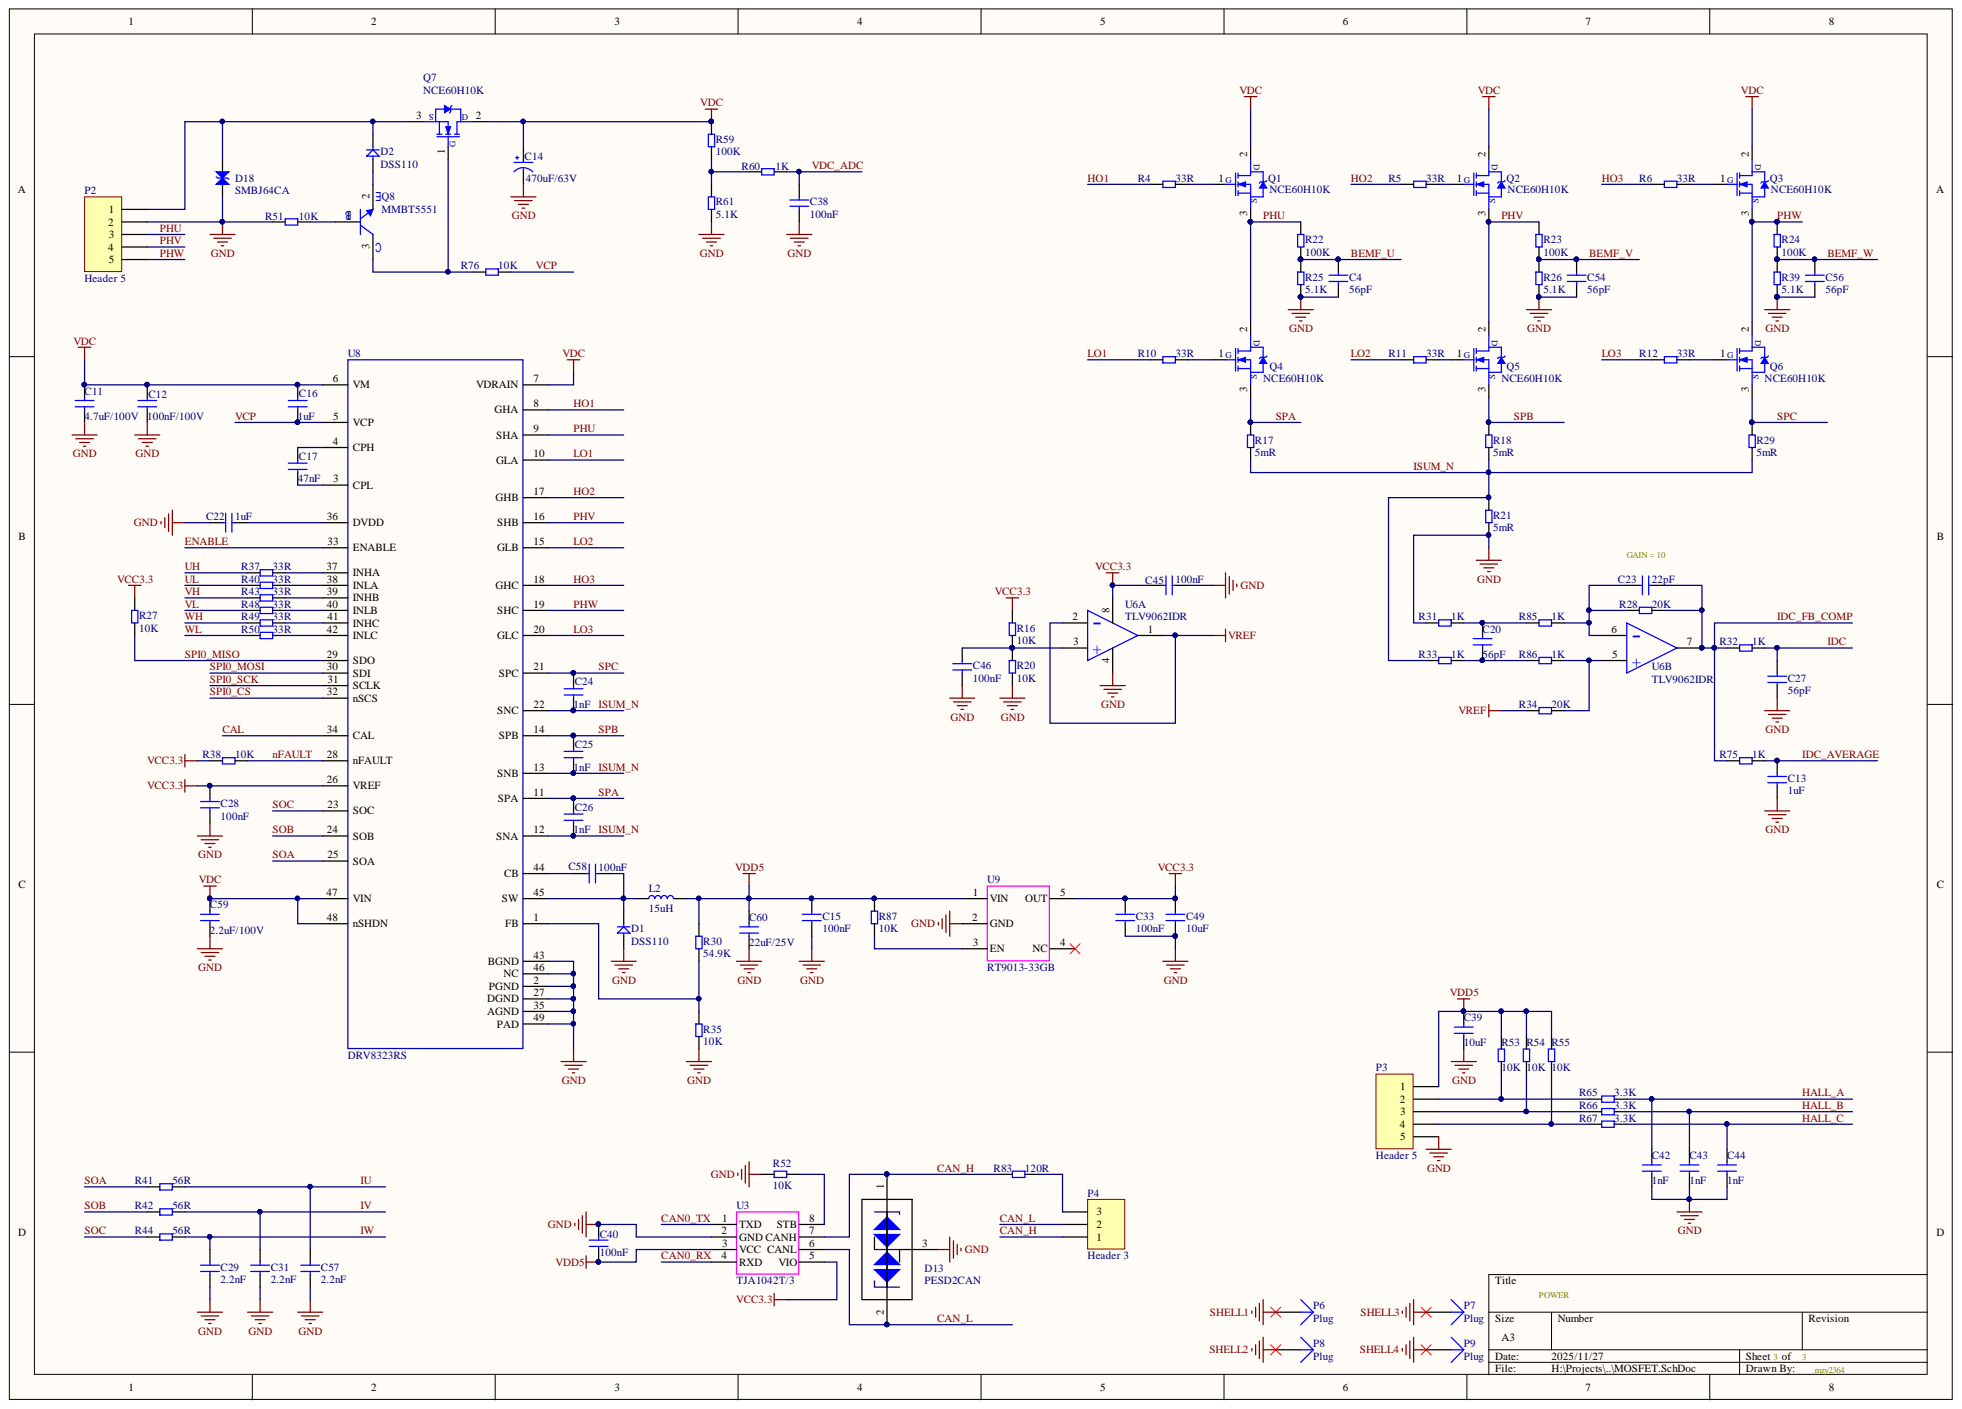
[picture p66: page 3]

nSHDN 48

VCC 3 | | 3

CAN_L
