mzy2364/MC_GD32/Hardware/Motor_Control_GD32_V4_2_Layout.pdf

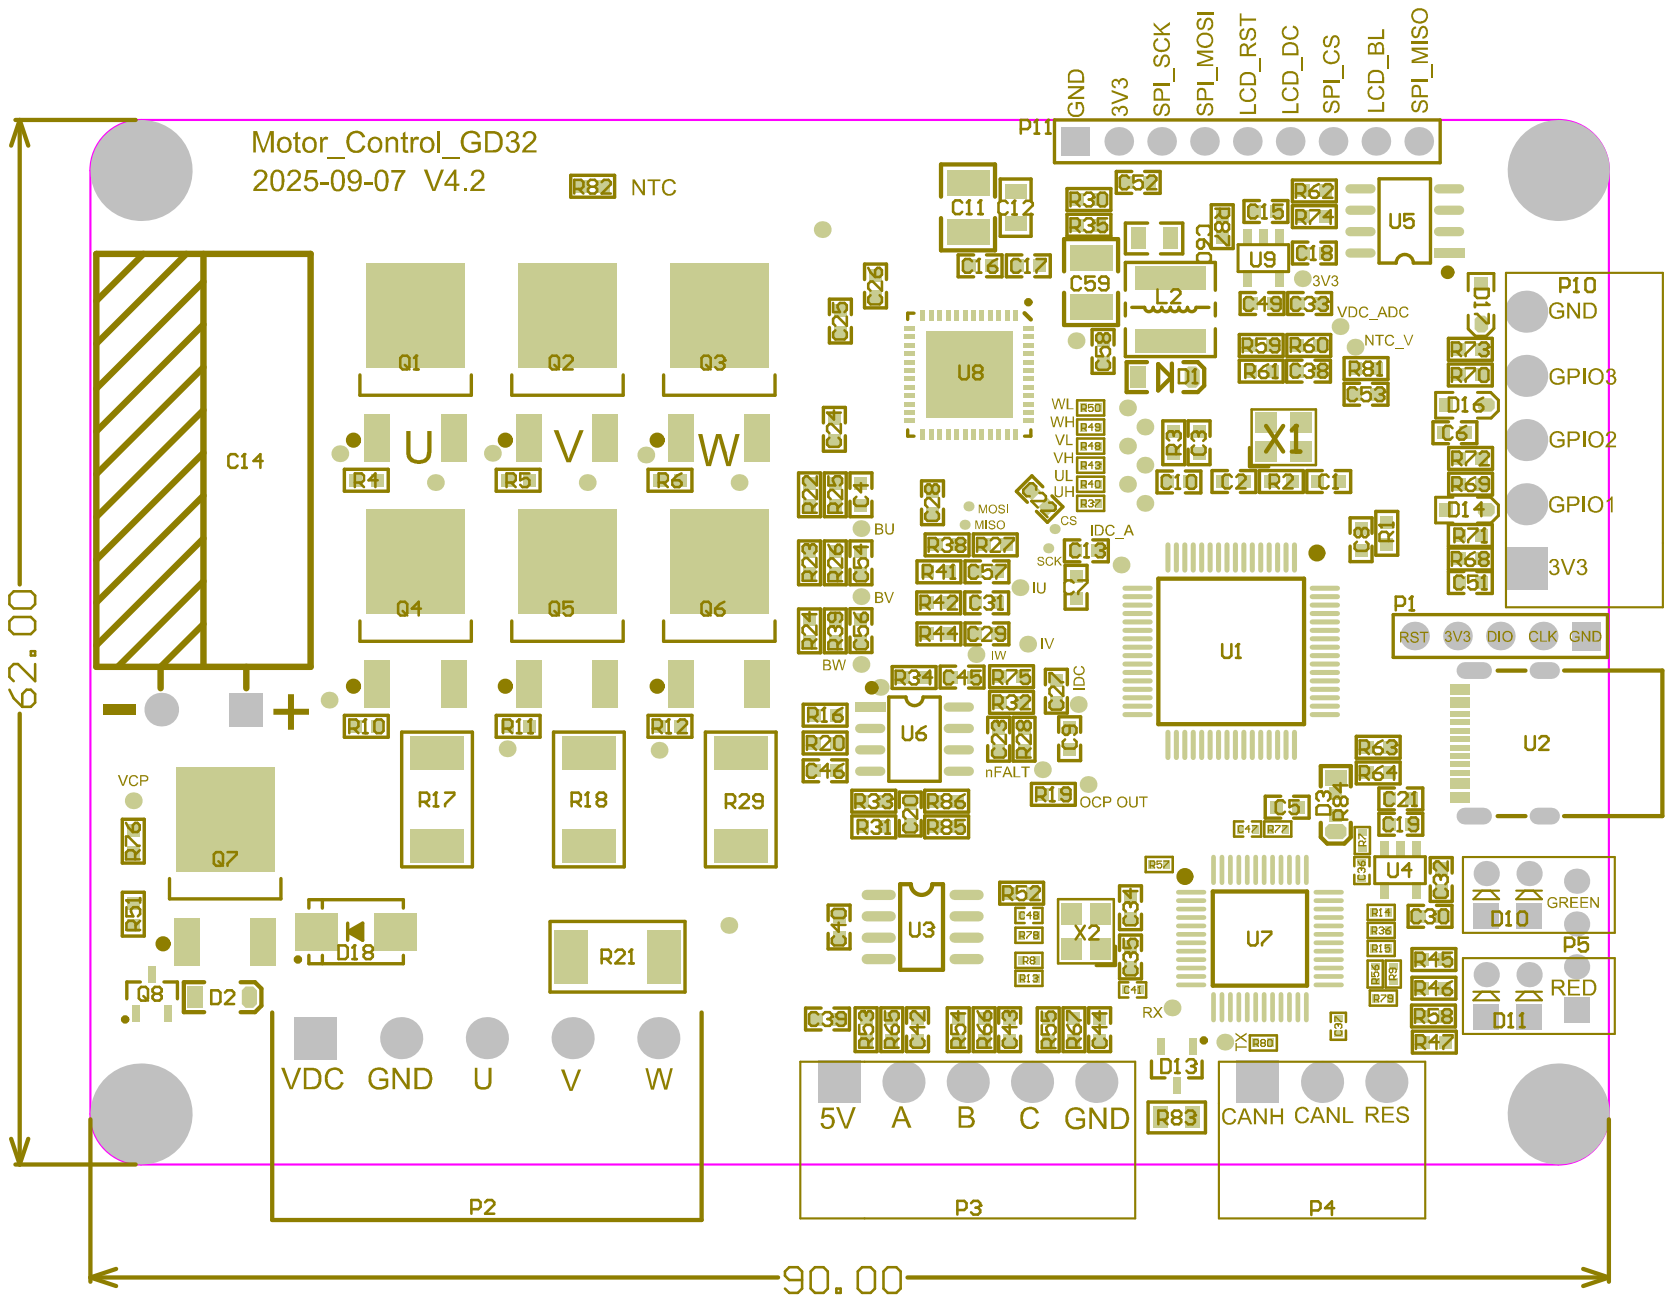
[picture p67: page 1]
