mzy2364/MC_GD32/FOC参考文档/AN1299调整指南.pdf

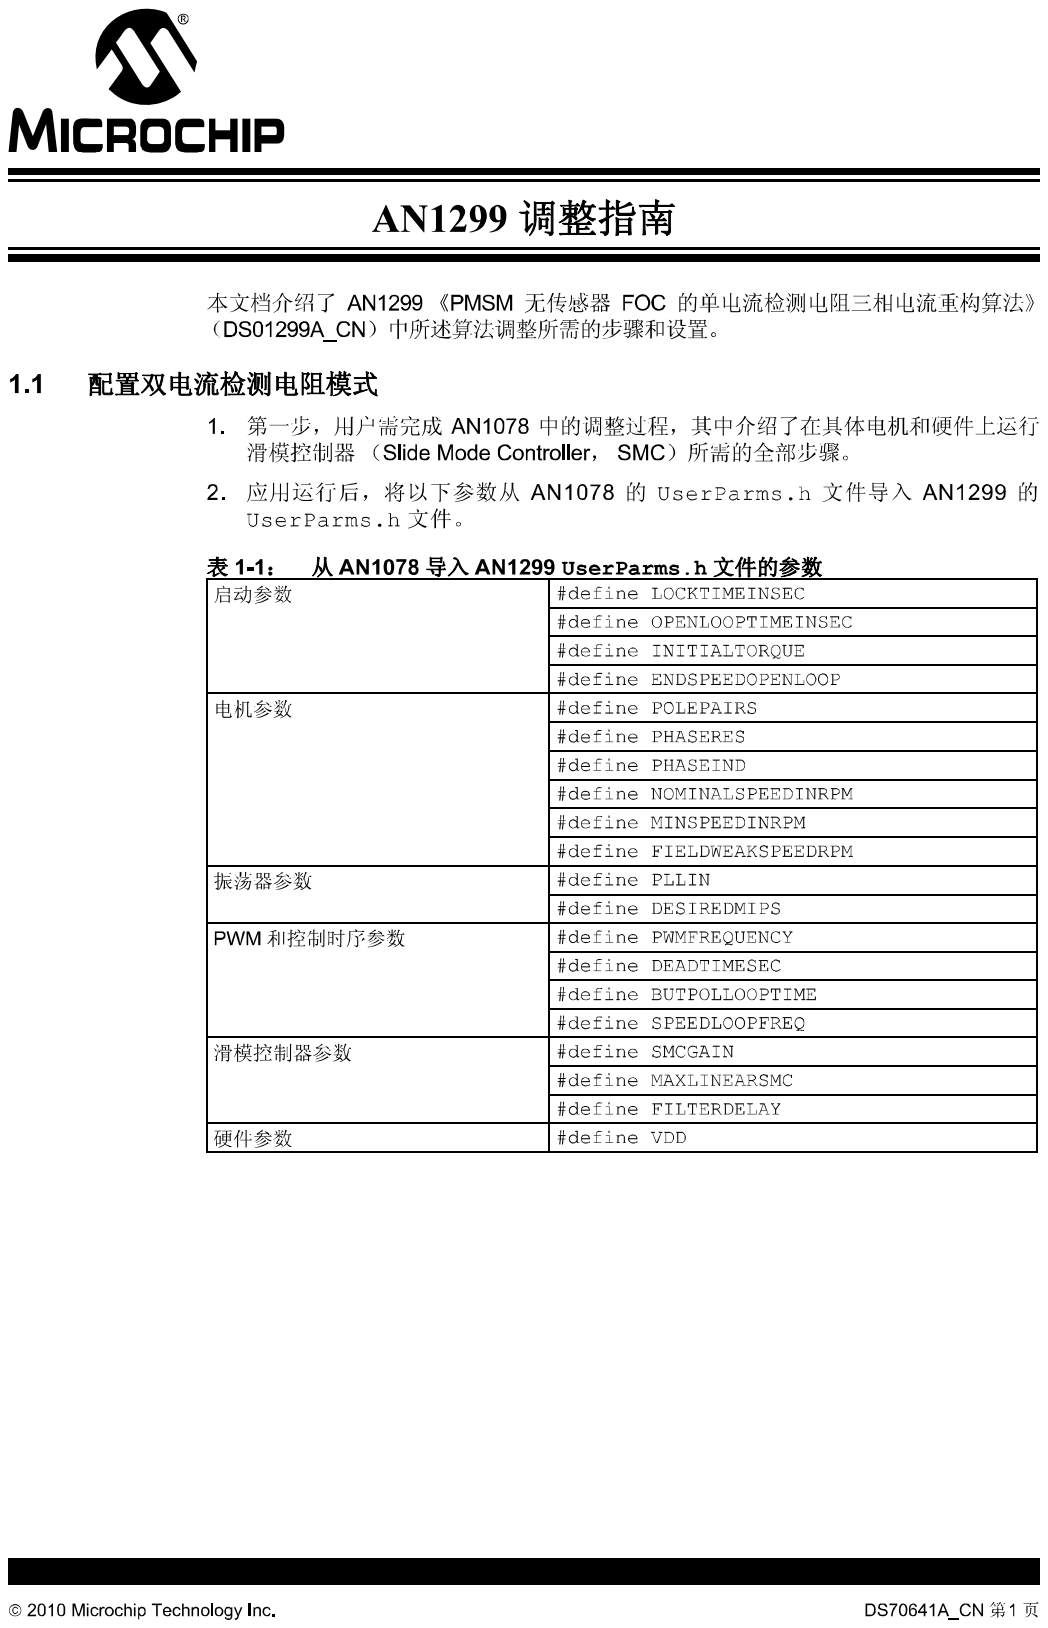
[picture p68: page 1]

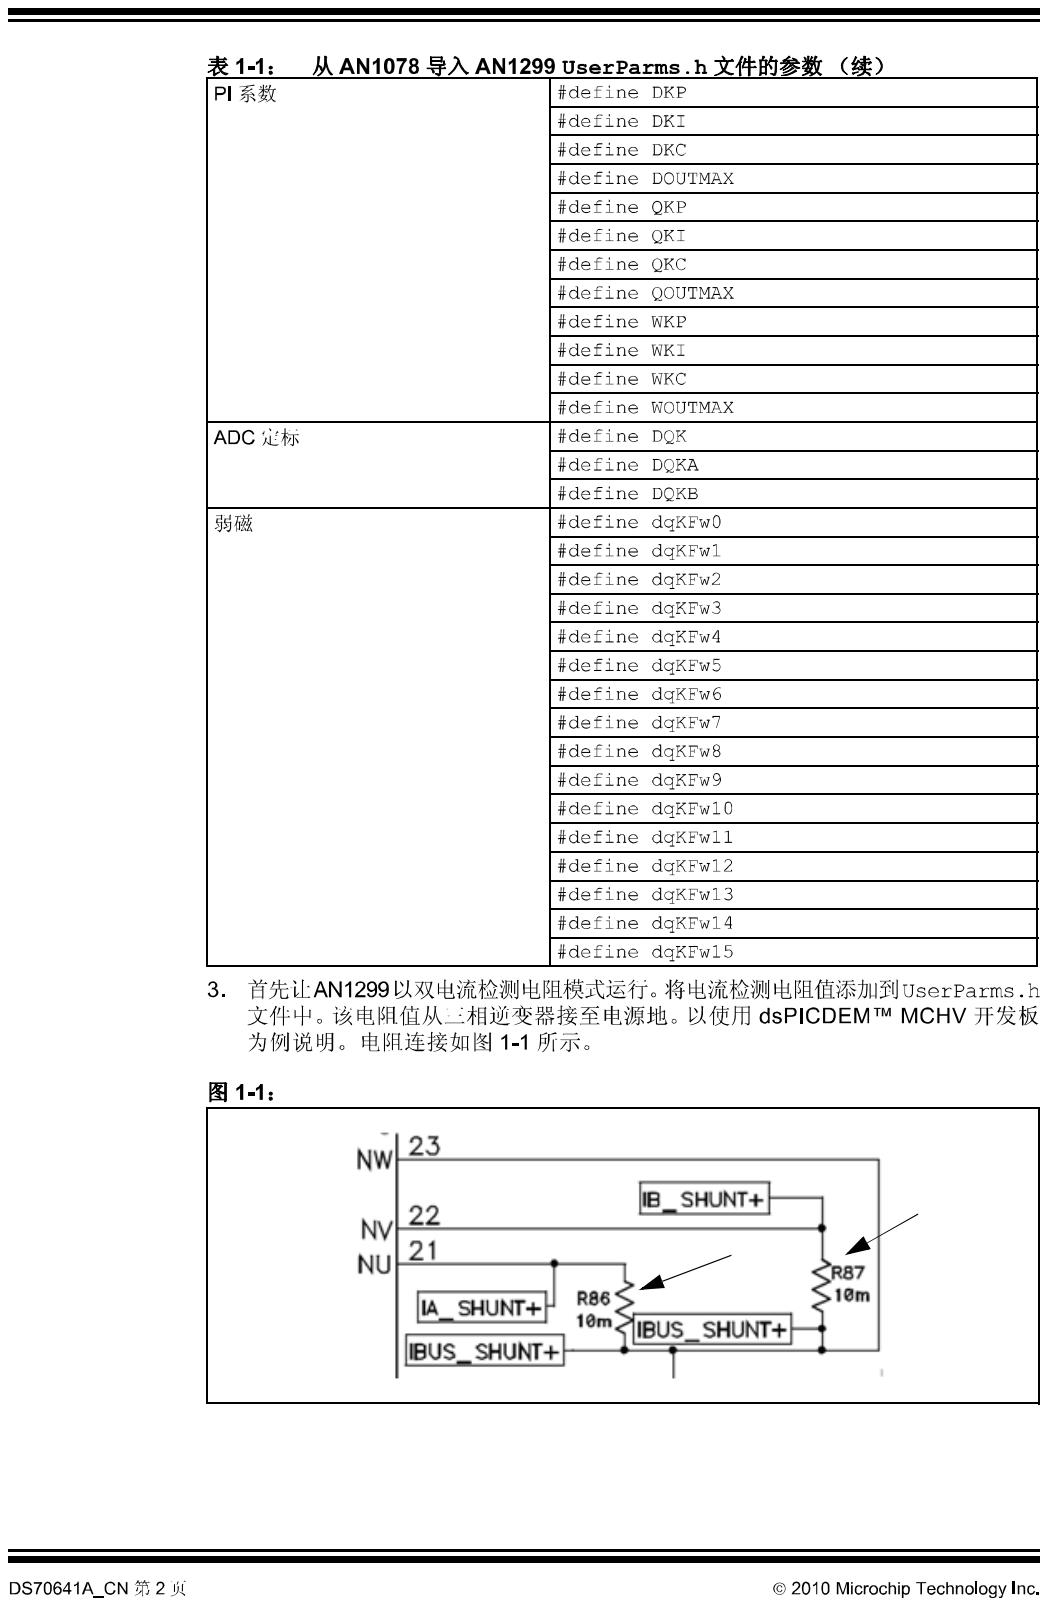
[picture p69: page 2]

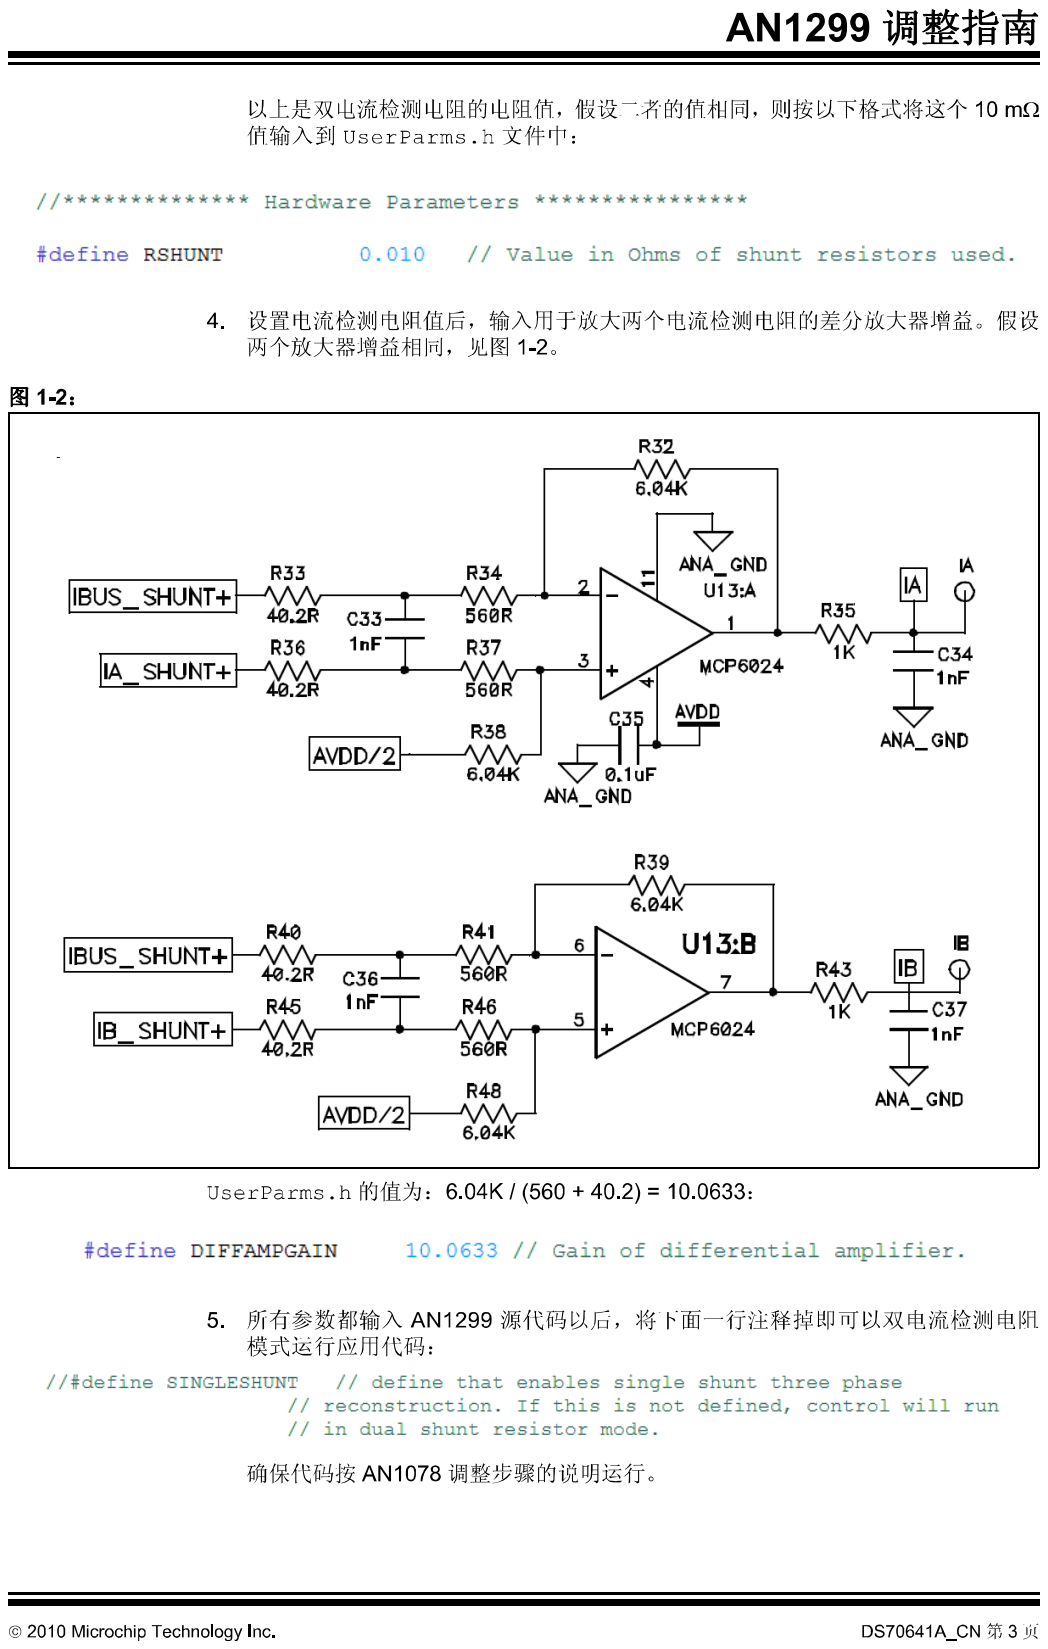
[picture p70: page 3]

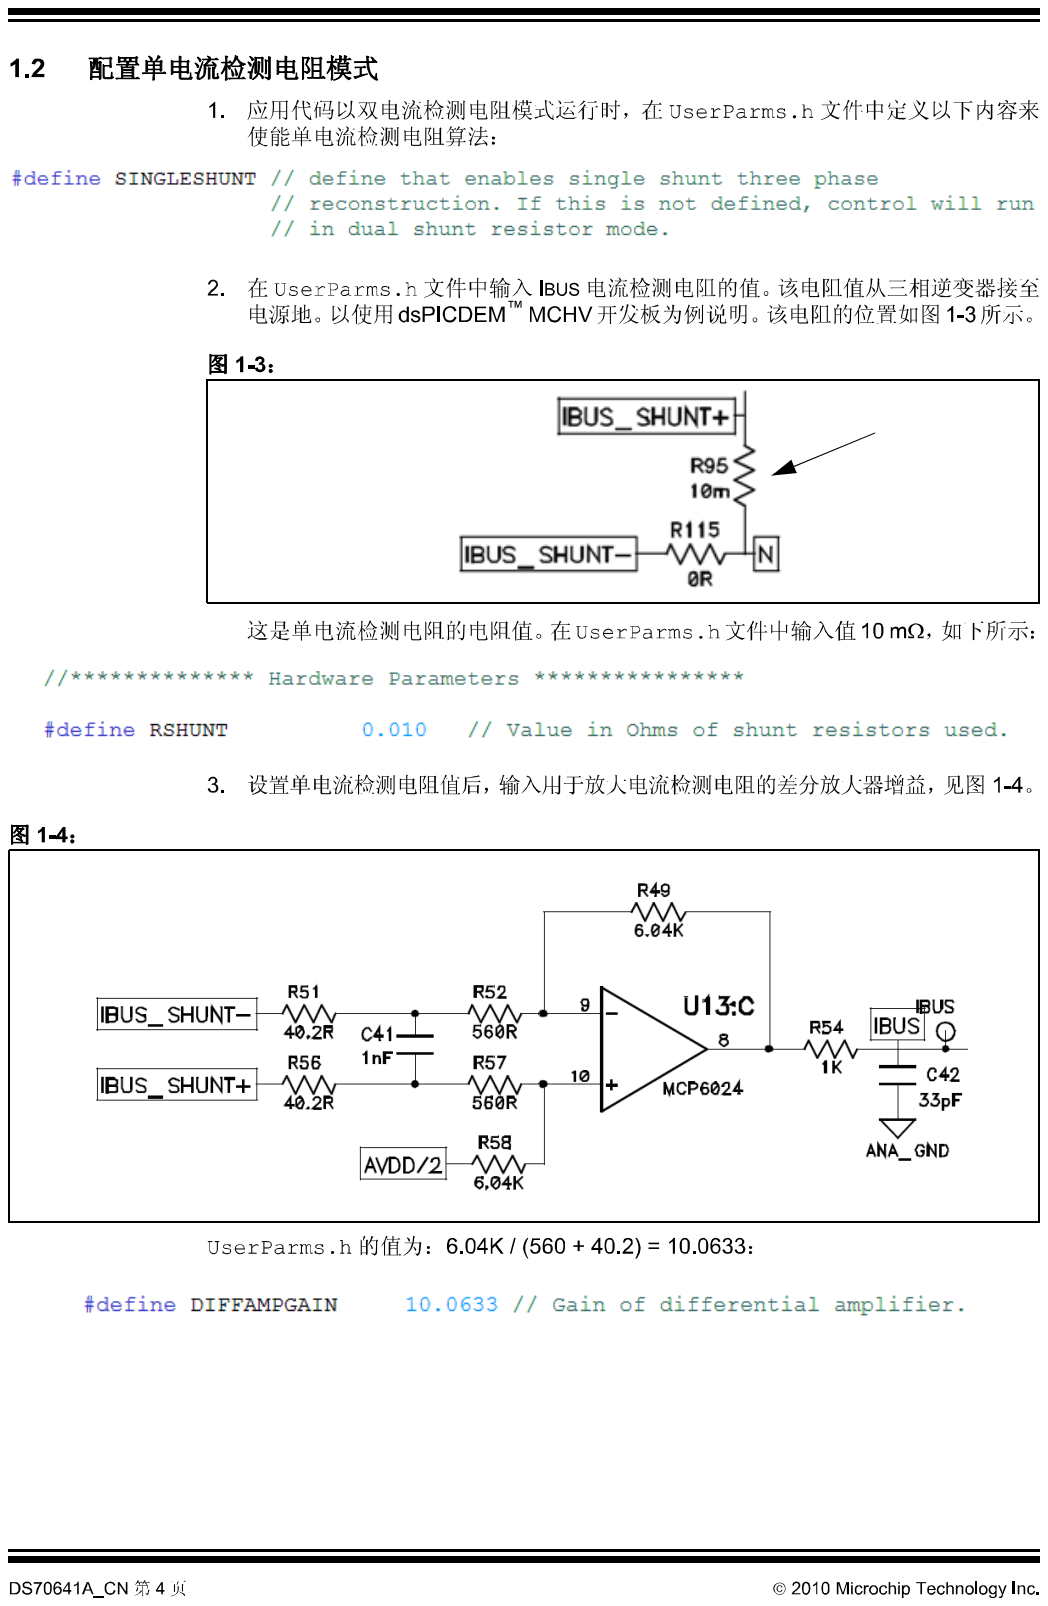
[picture p71: page 4]

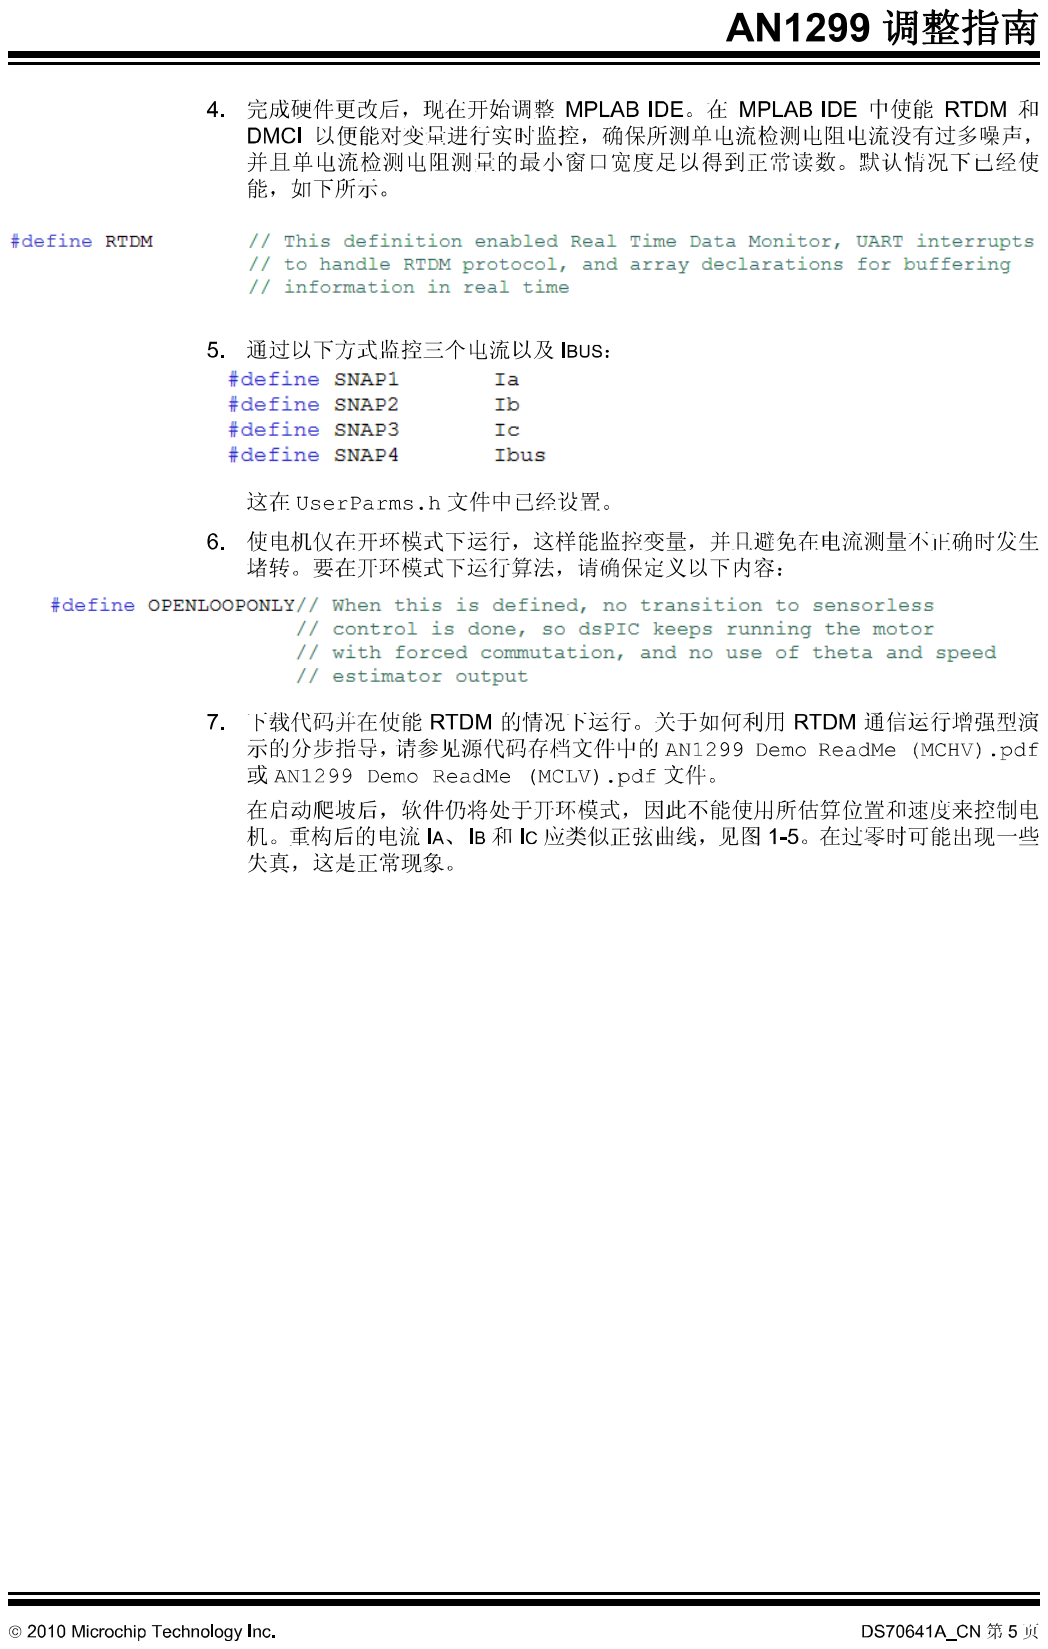
[picture p72: page 5]

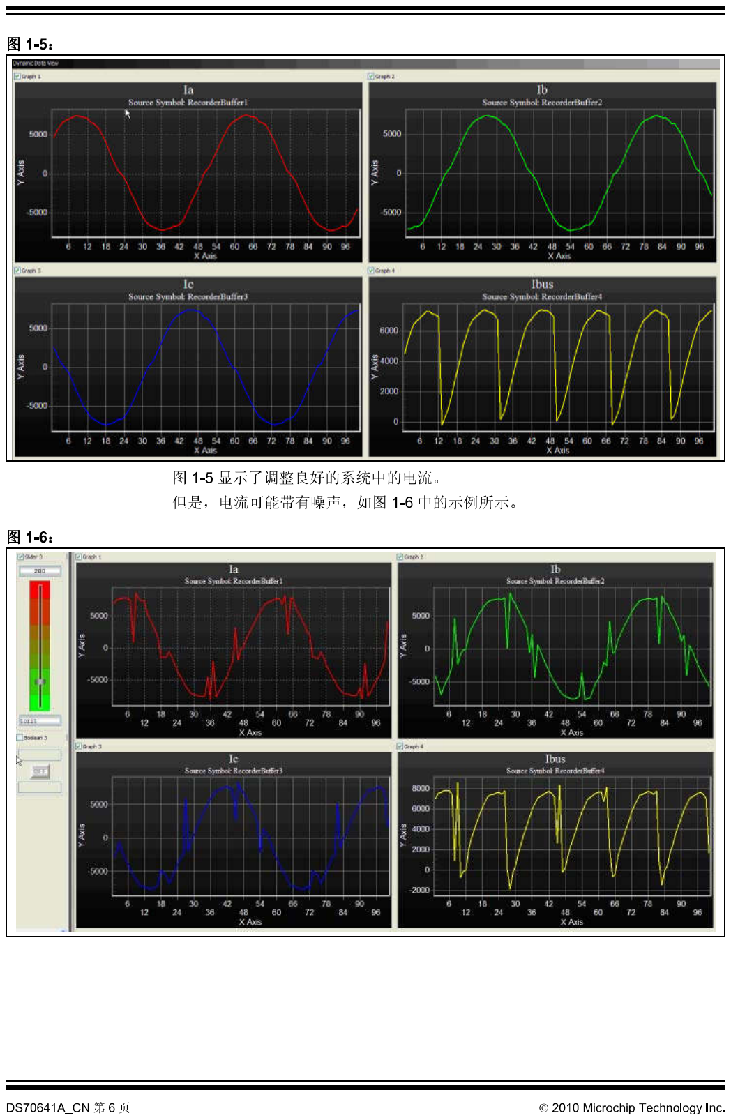
[picture p73: page 6]

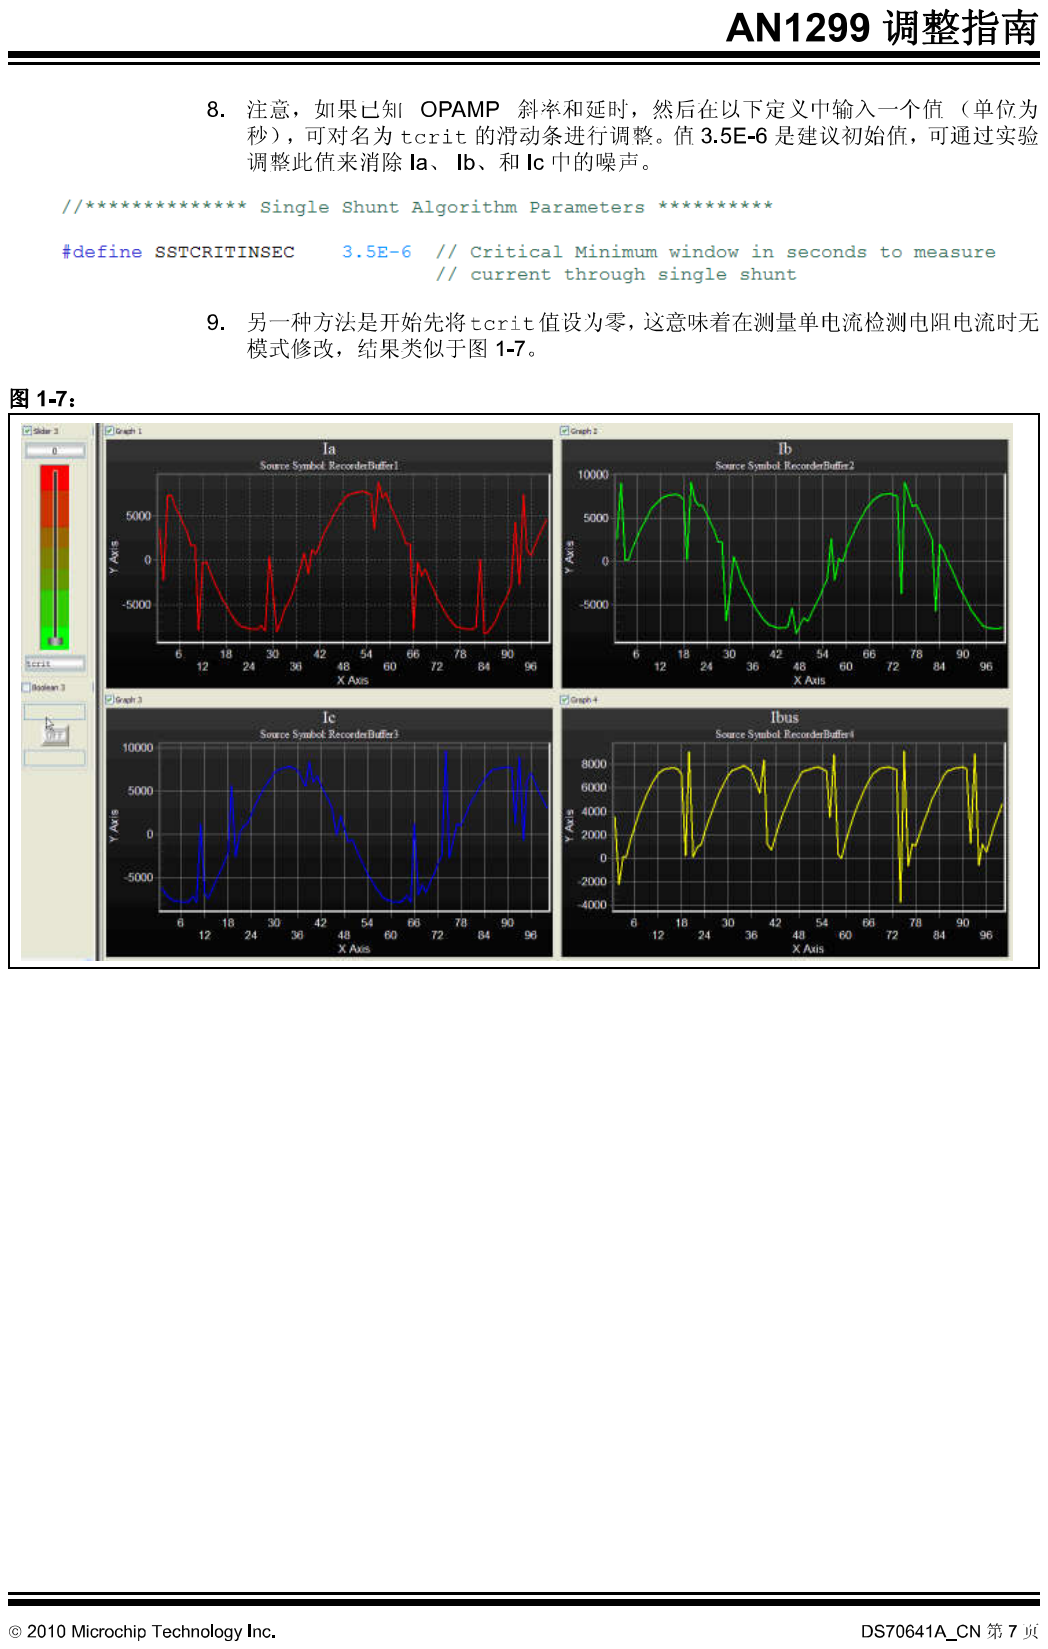
[picture p74: page 7]

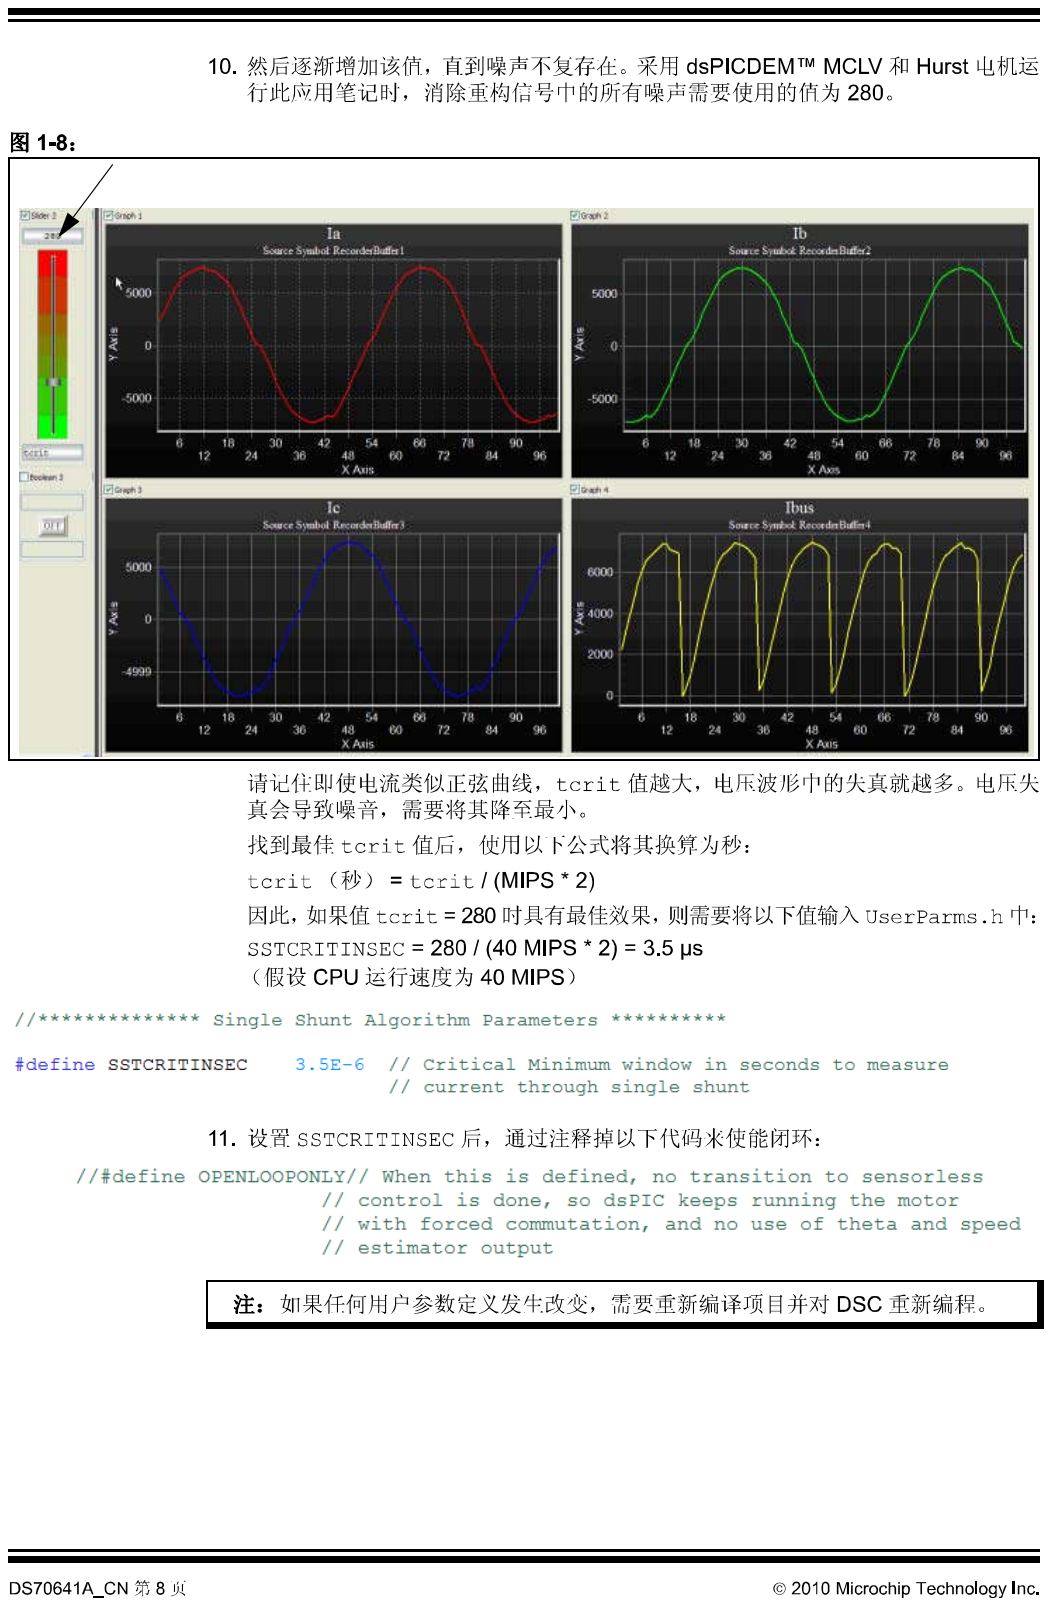
[picture p75: page 8]

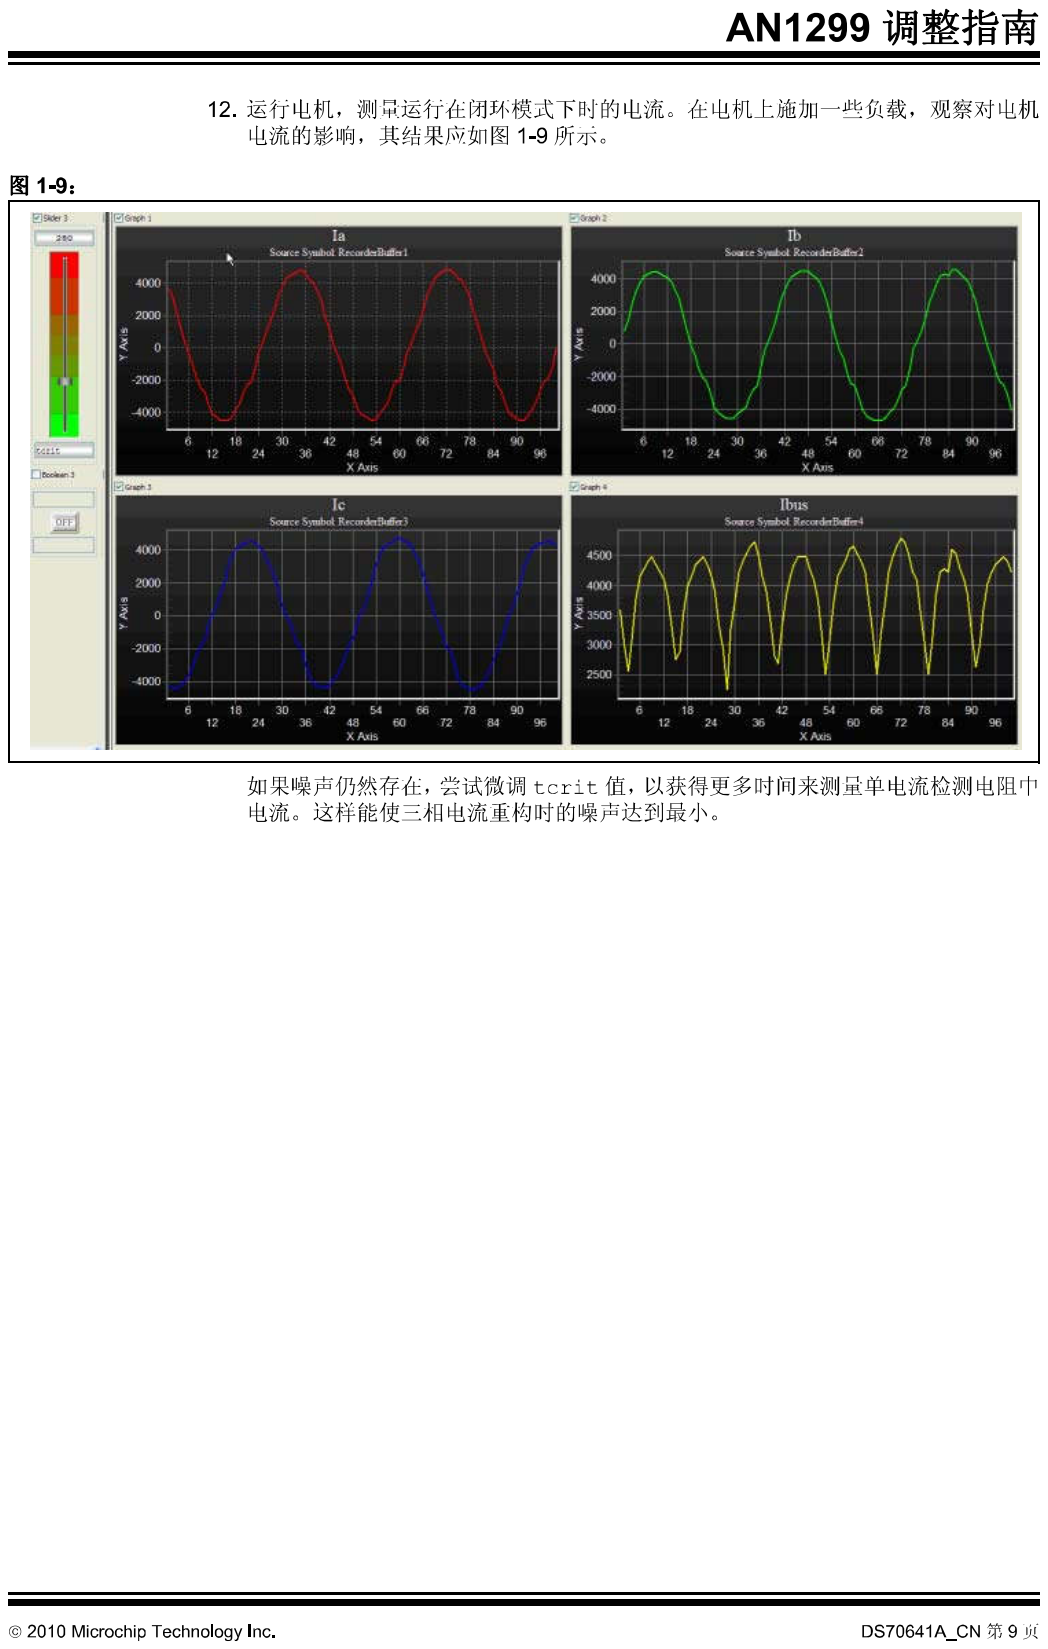
[picture p76: page 9]

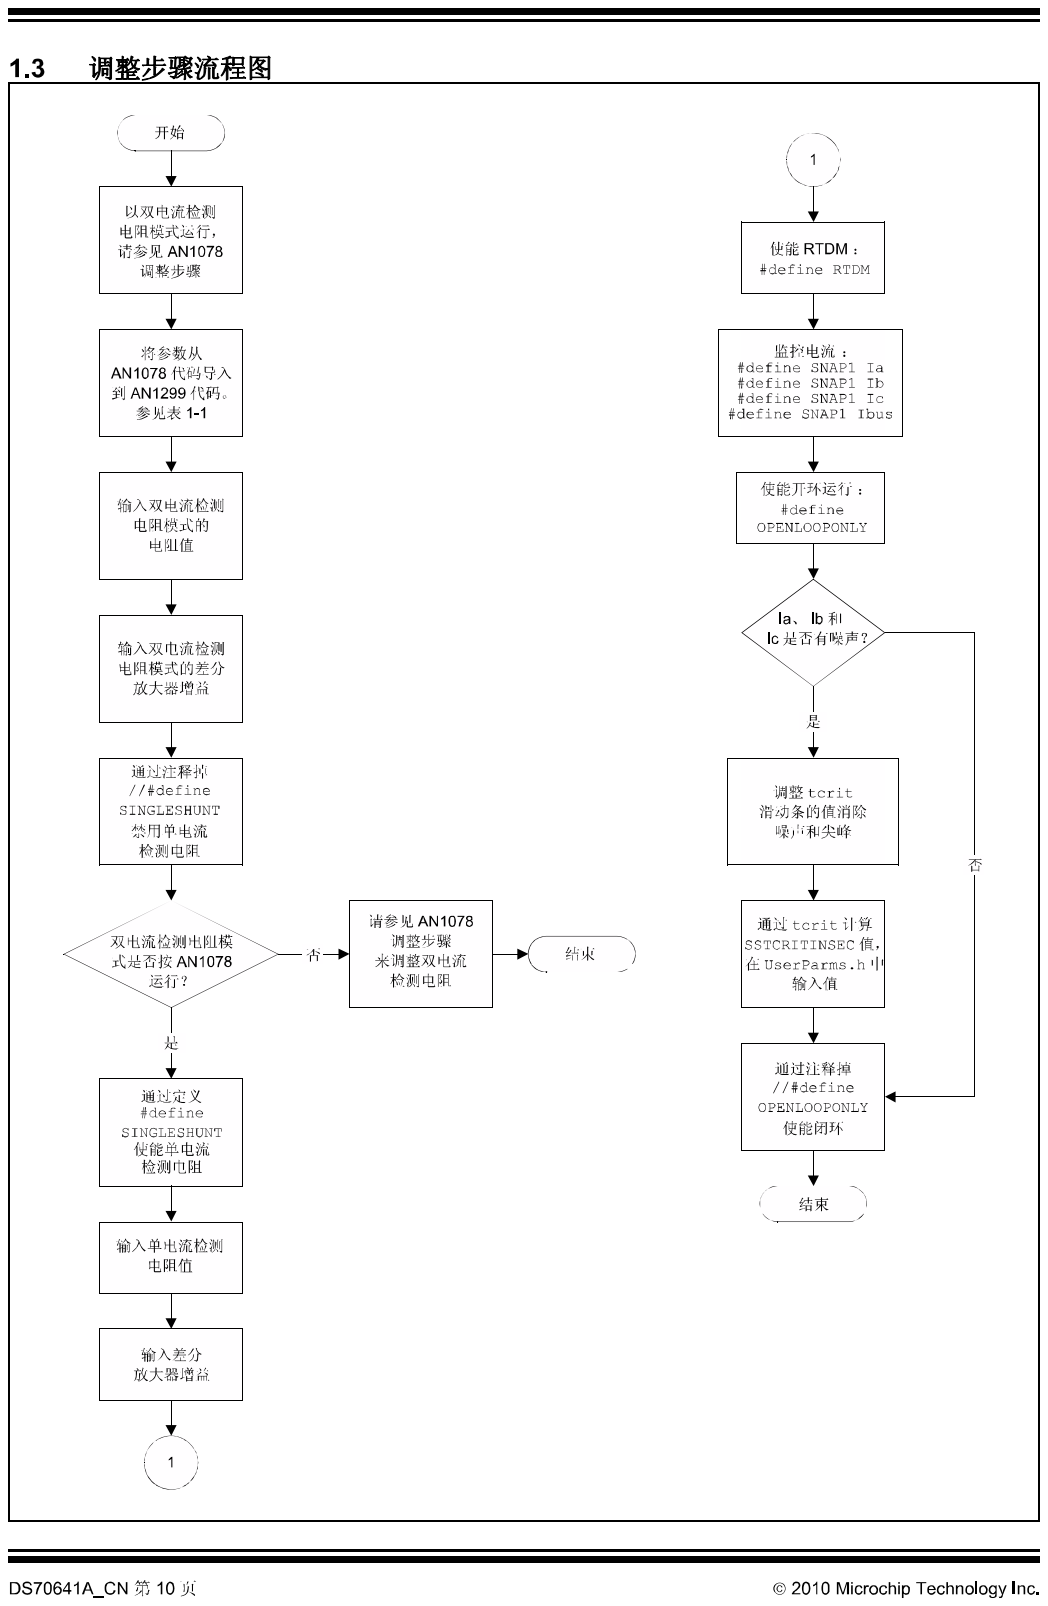
[picture p77: page 10]

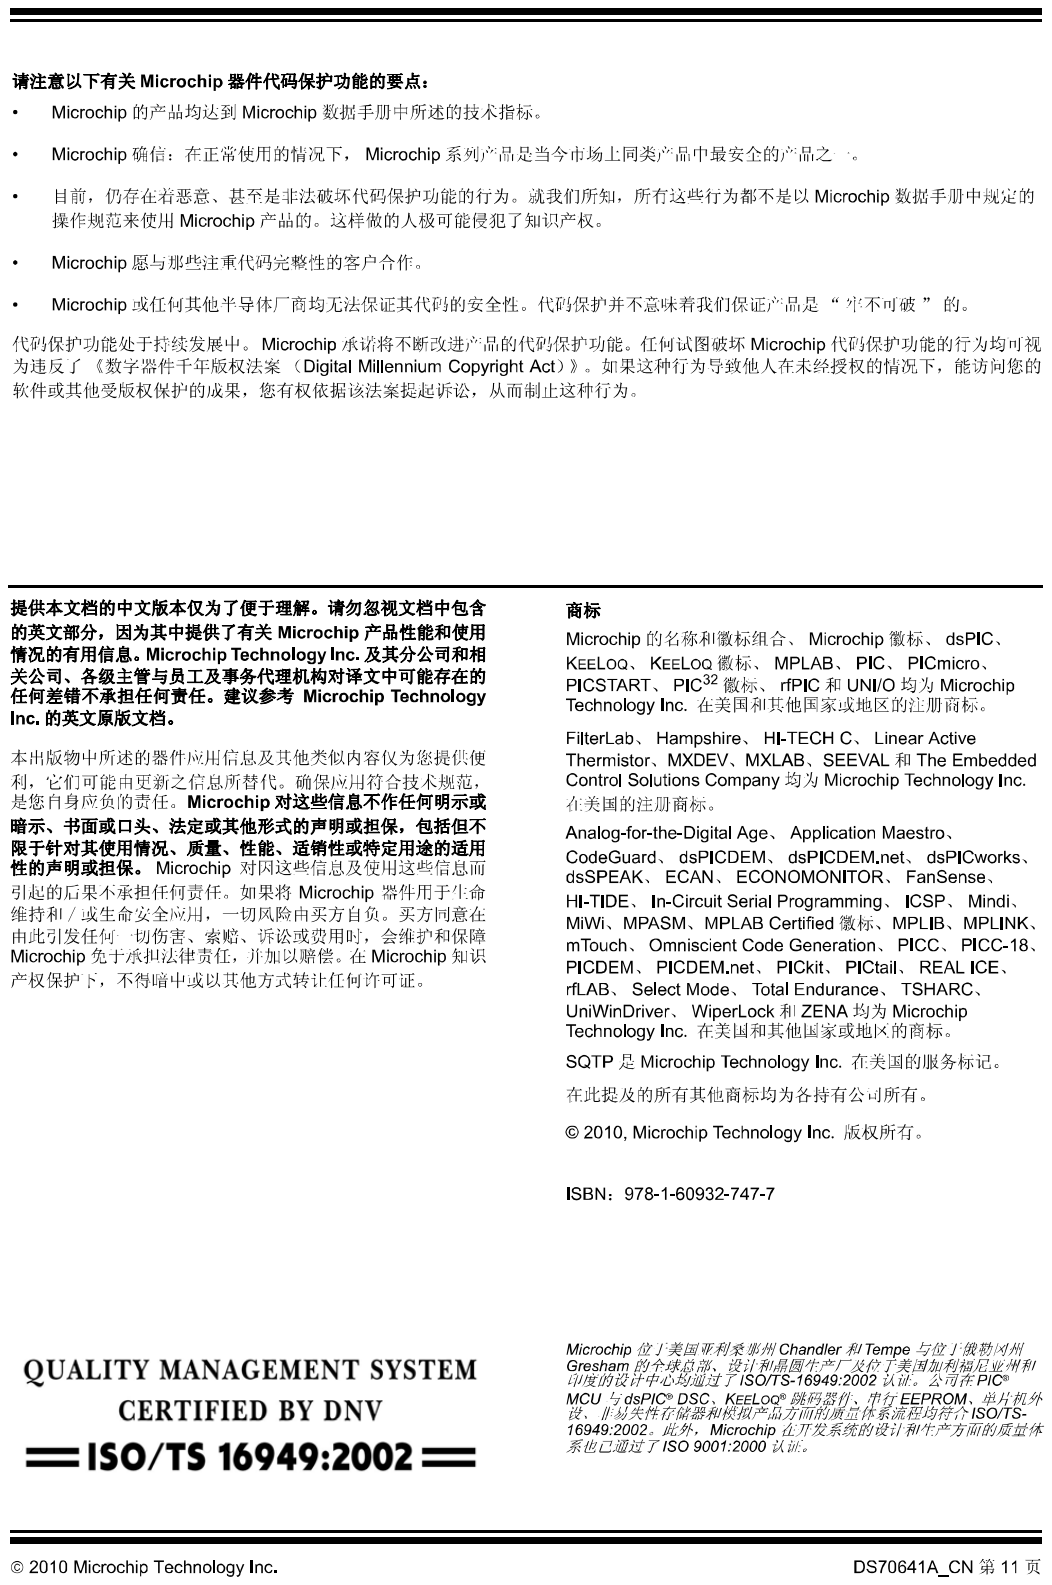
[picture p78: page 11]

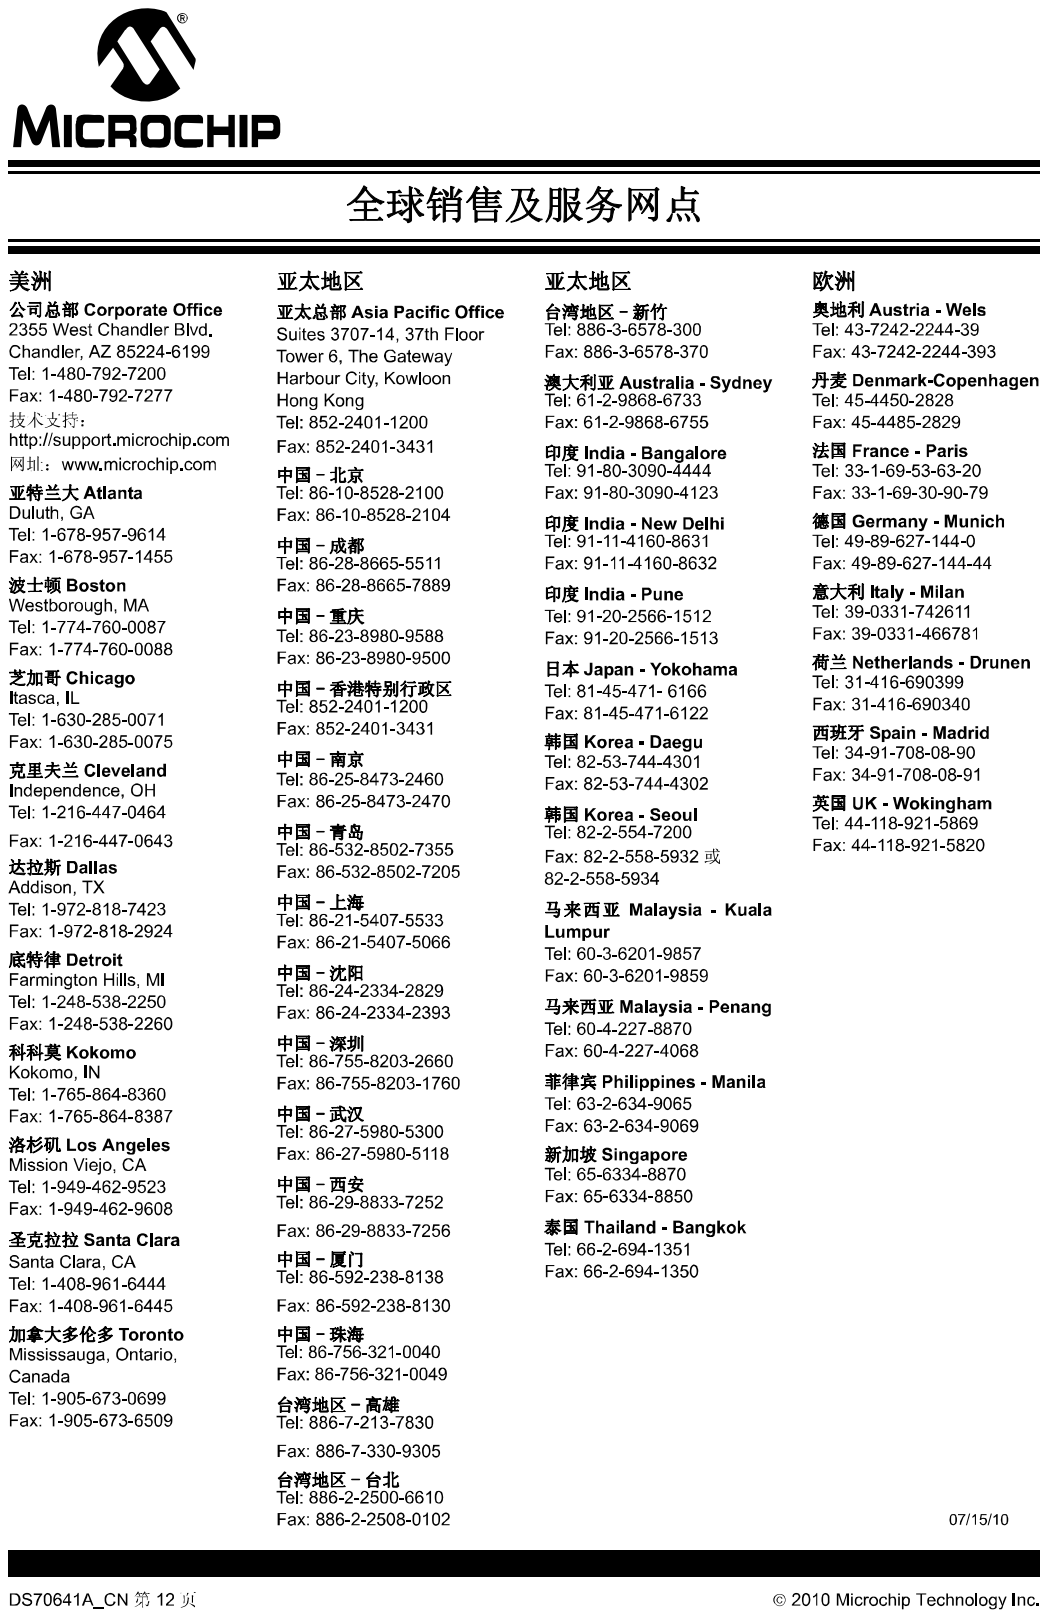
[picture p79: page 12]
