mzy2364/MC_GD32/Hardware/Motor_Control_GD32_V4_1.pdf

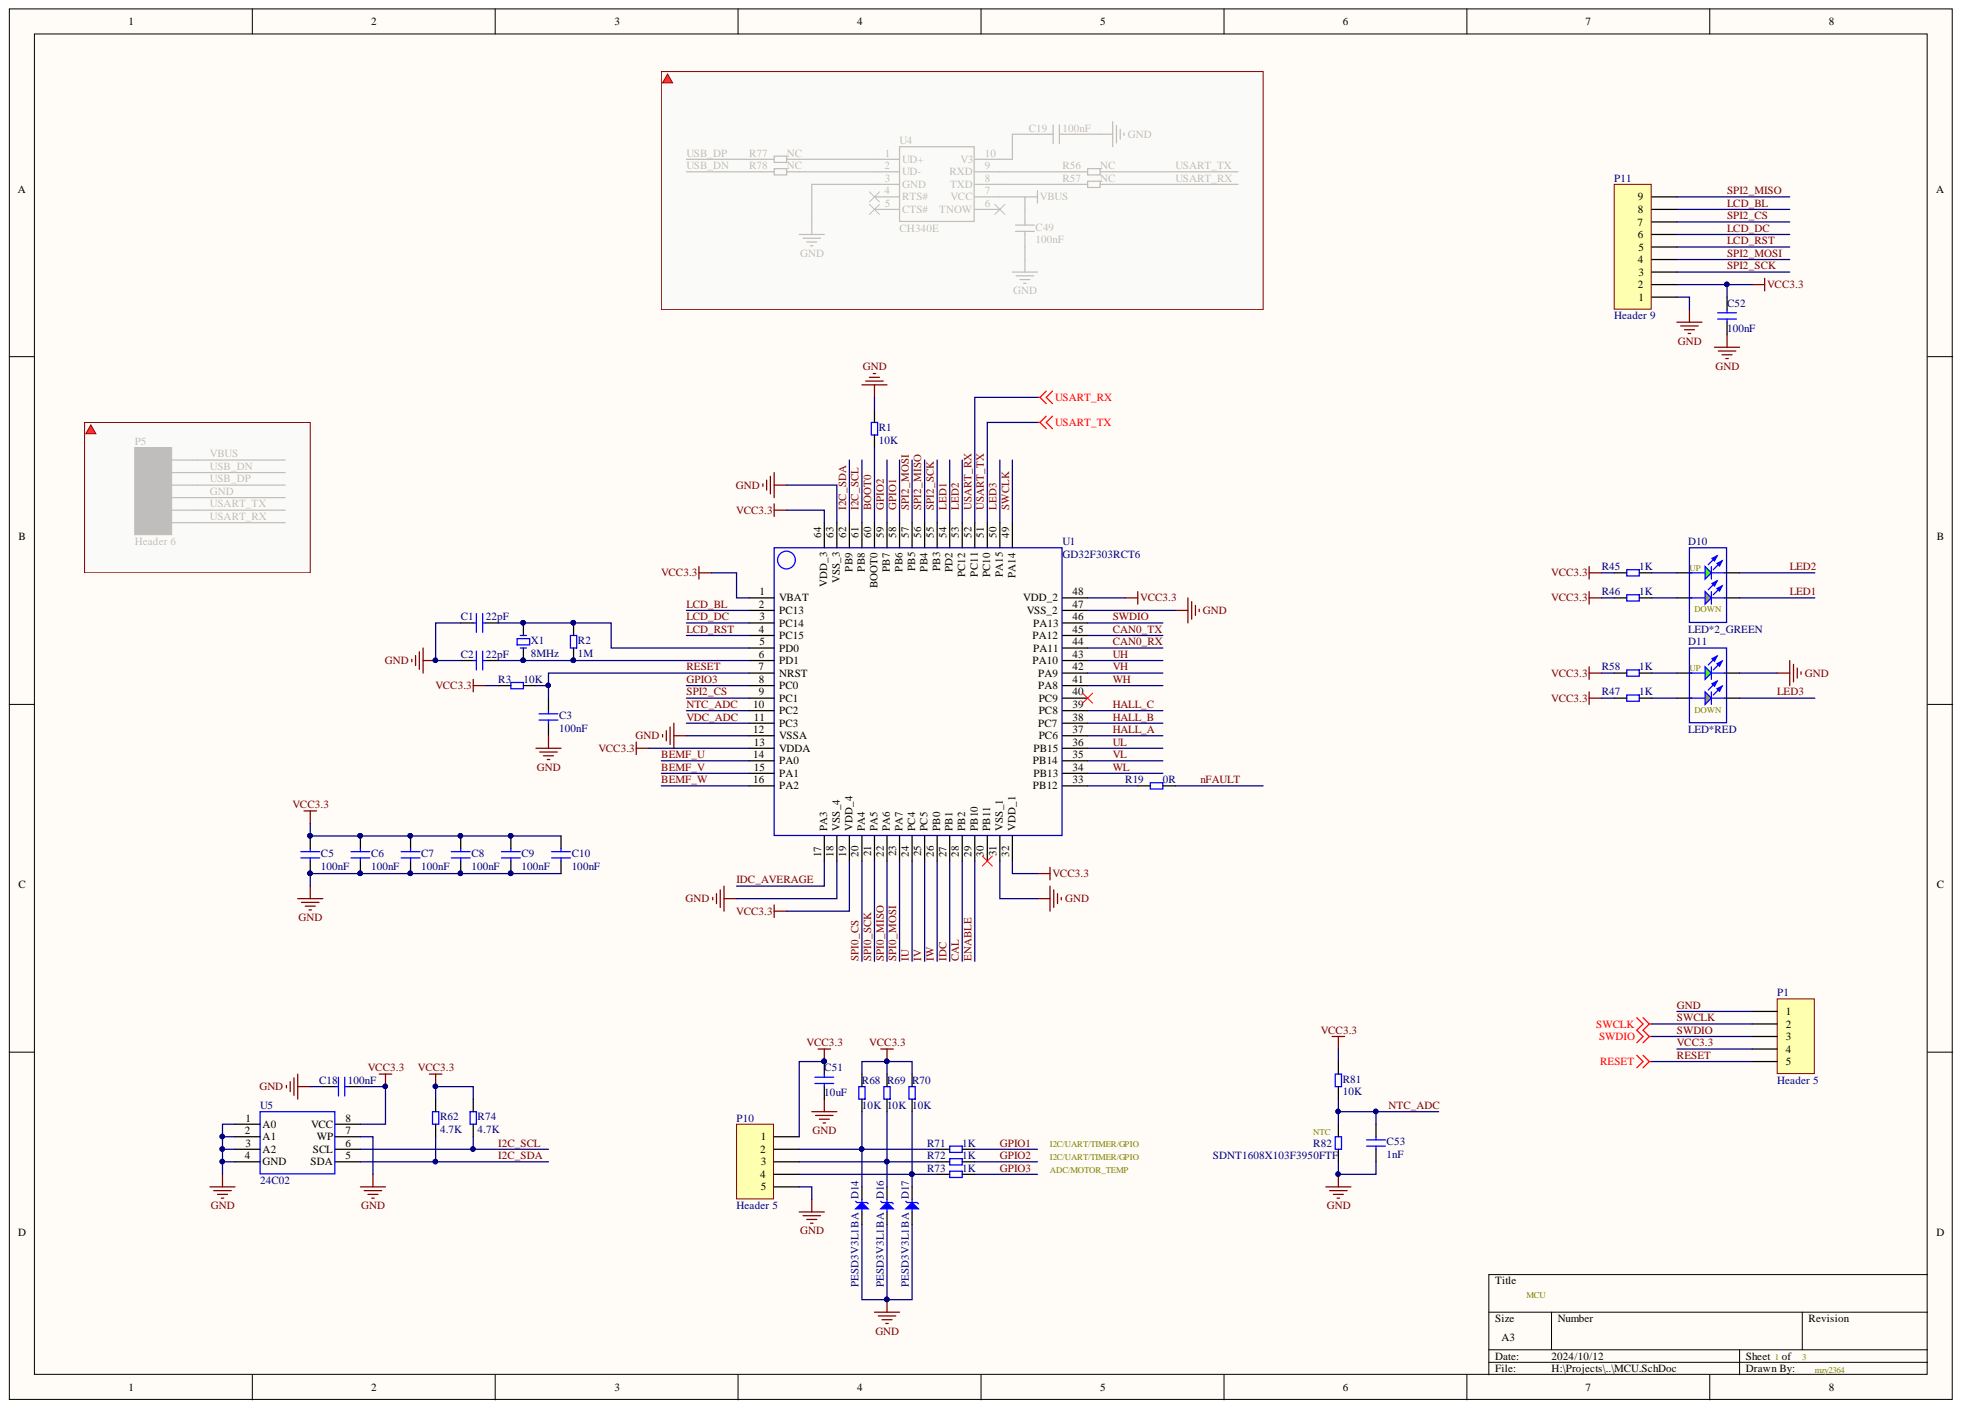
[picture p80: page 1]

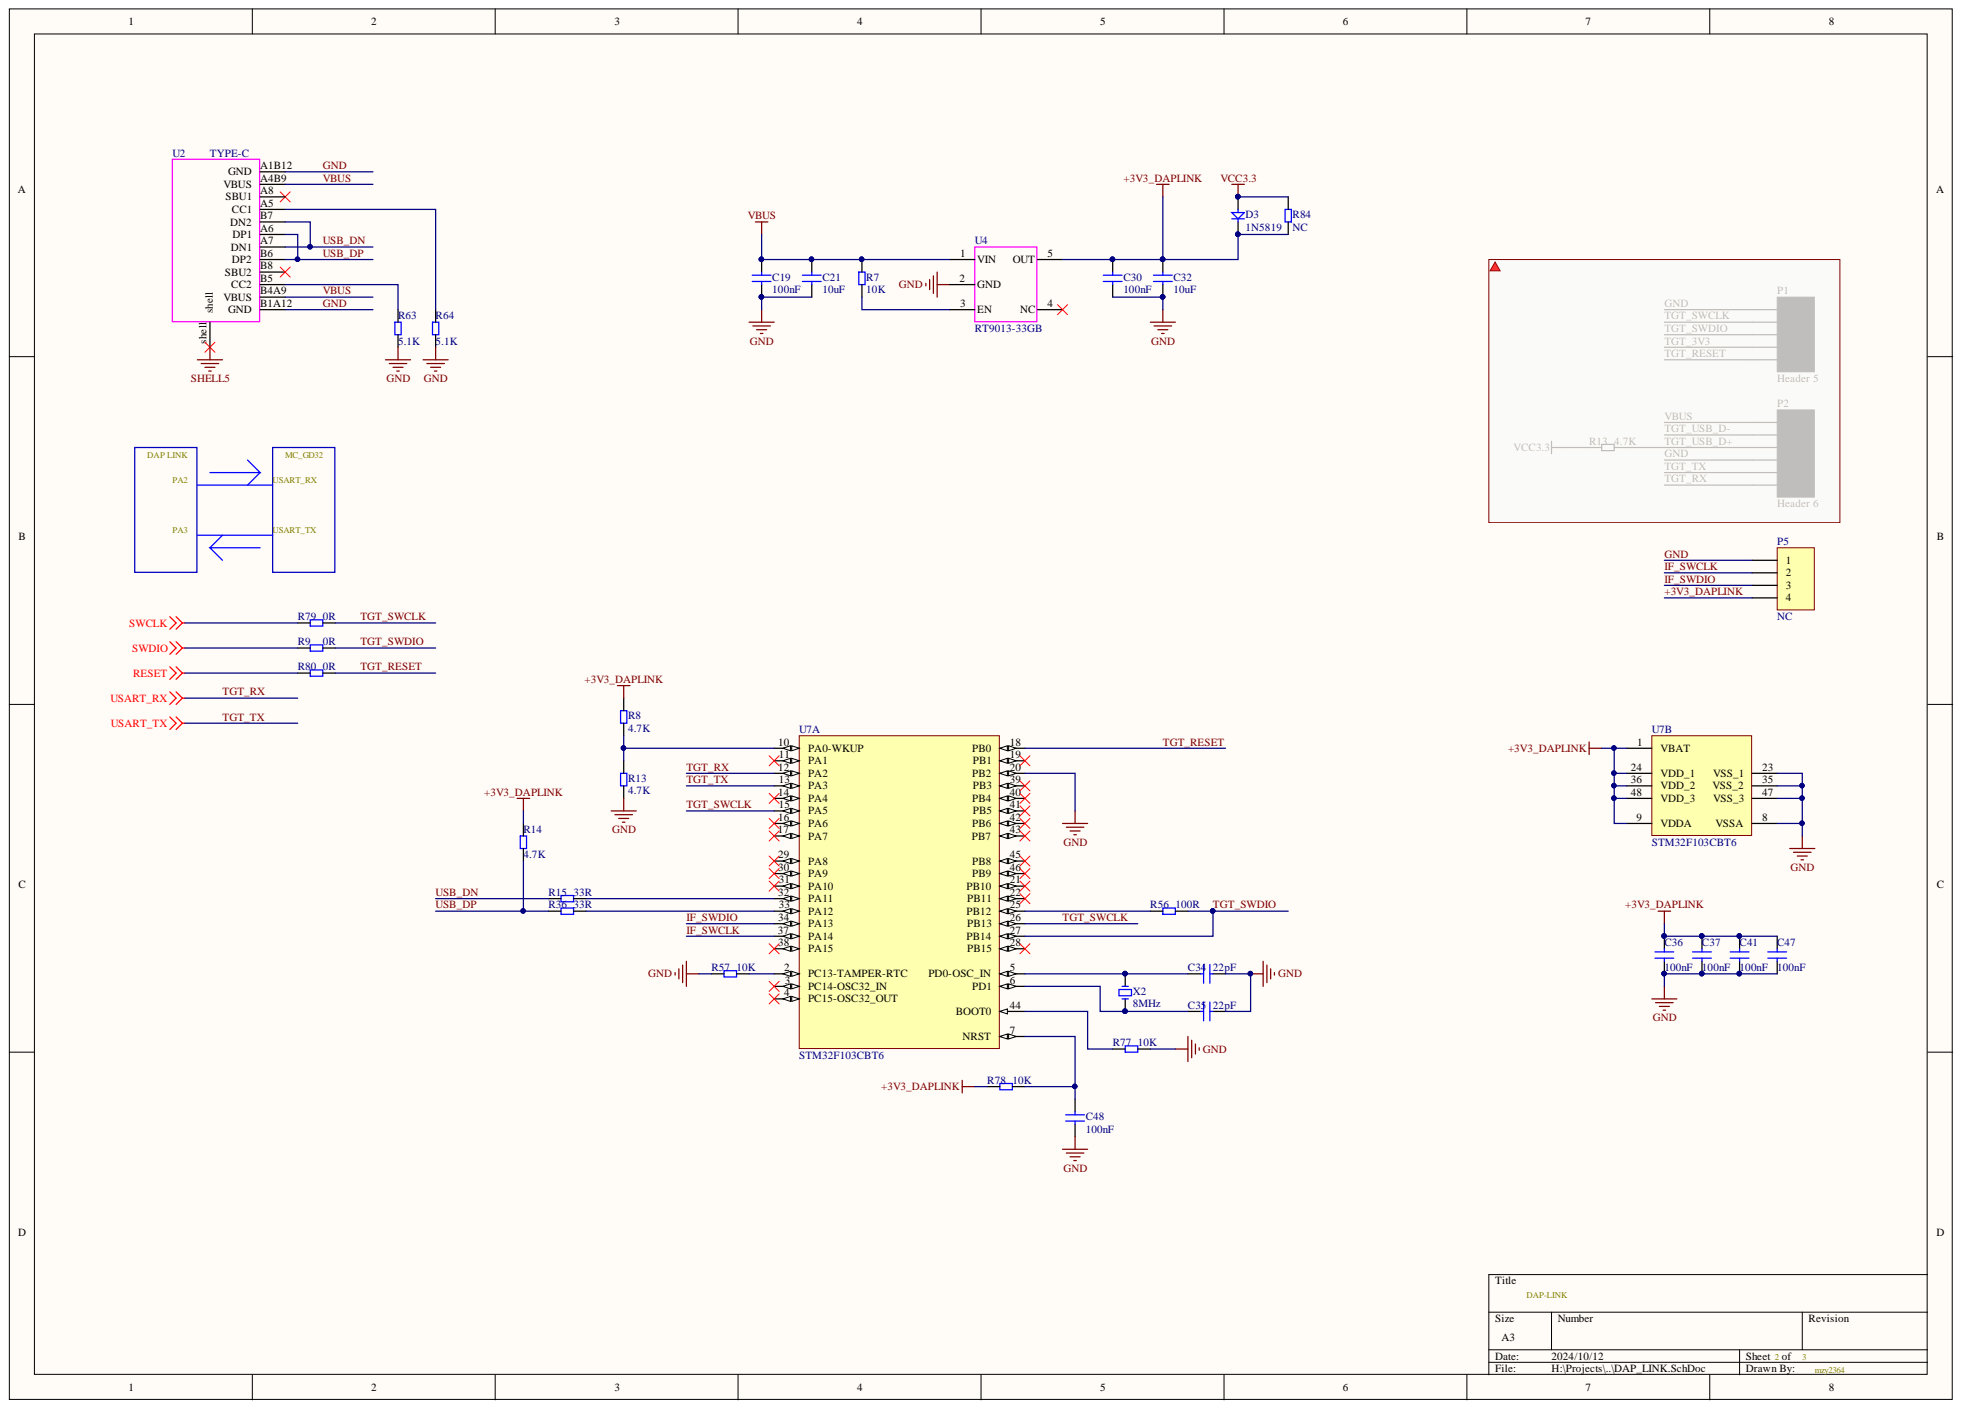
[picture p81: page 2]

GND 2 | C30 | P1

VBUS GND

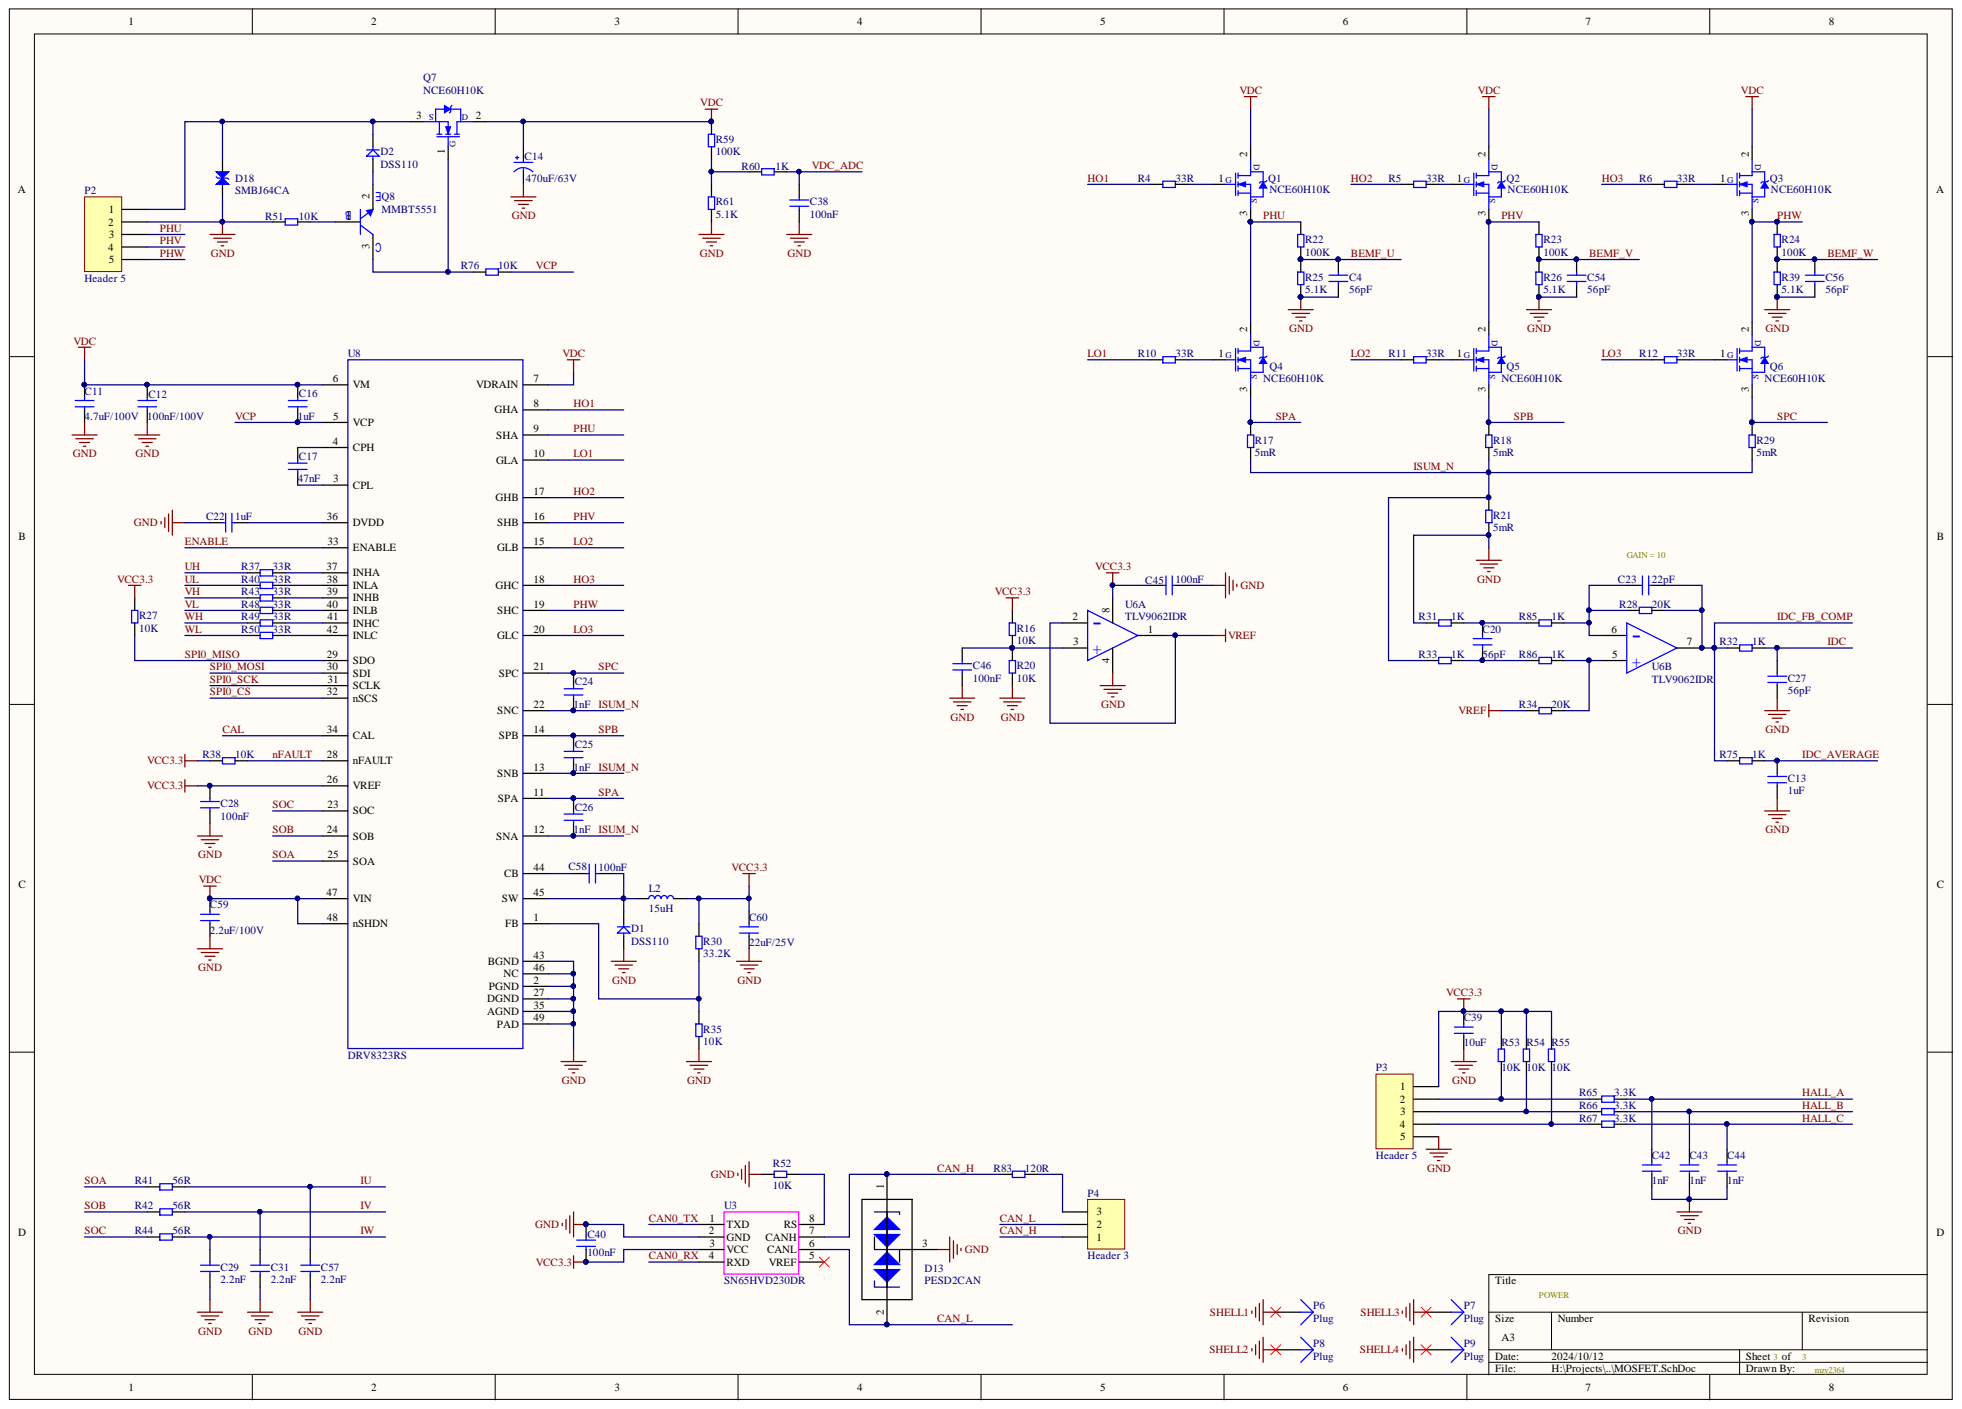
[picture p82: page 3]

nSHDN 48

VCC 3 | | 3

CAN_L
