mzy2364/MC_GD32/Hardware/Motor_Control_GD32_V4_1_Layout.pdf

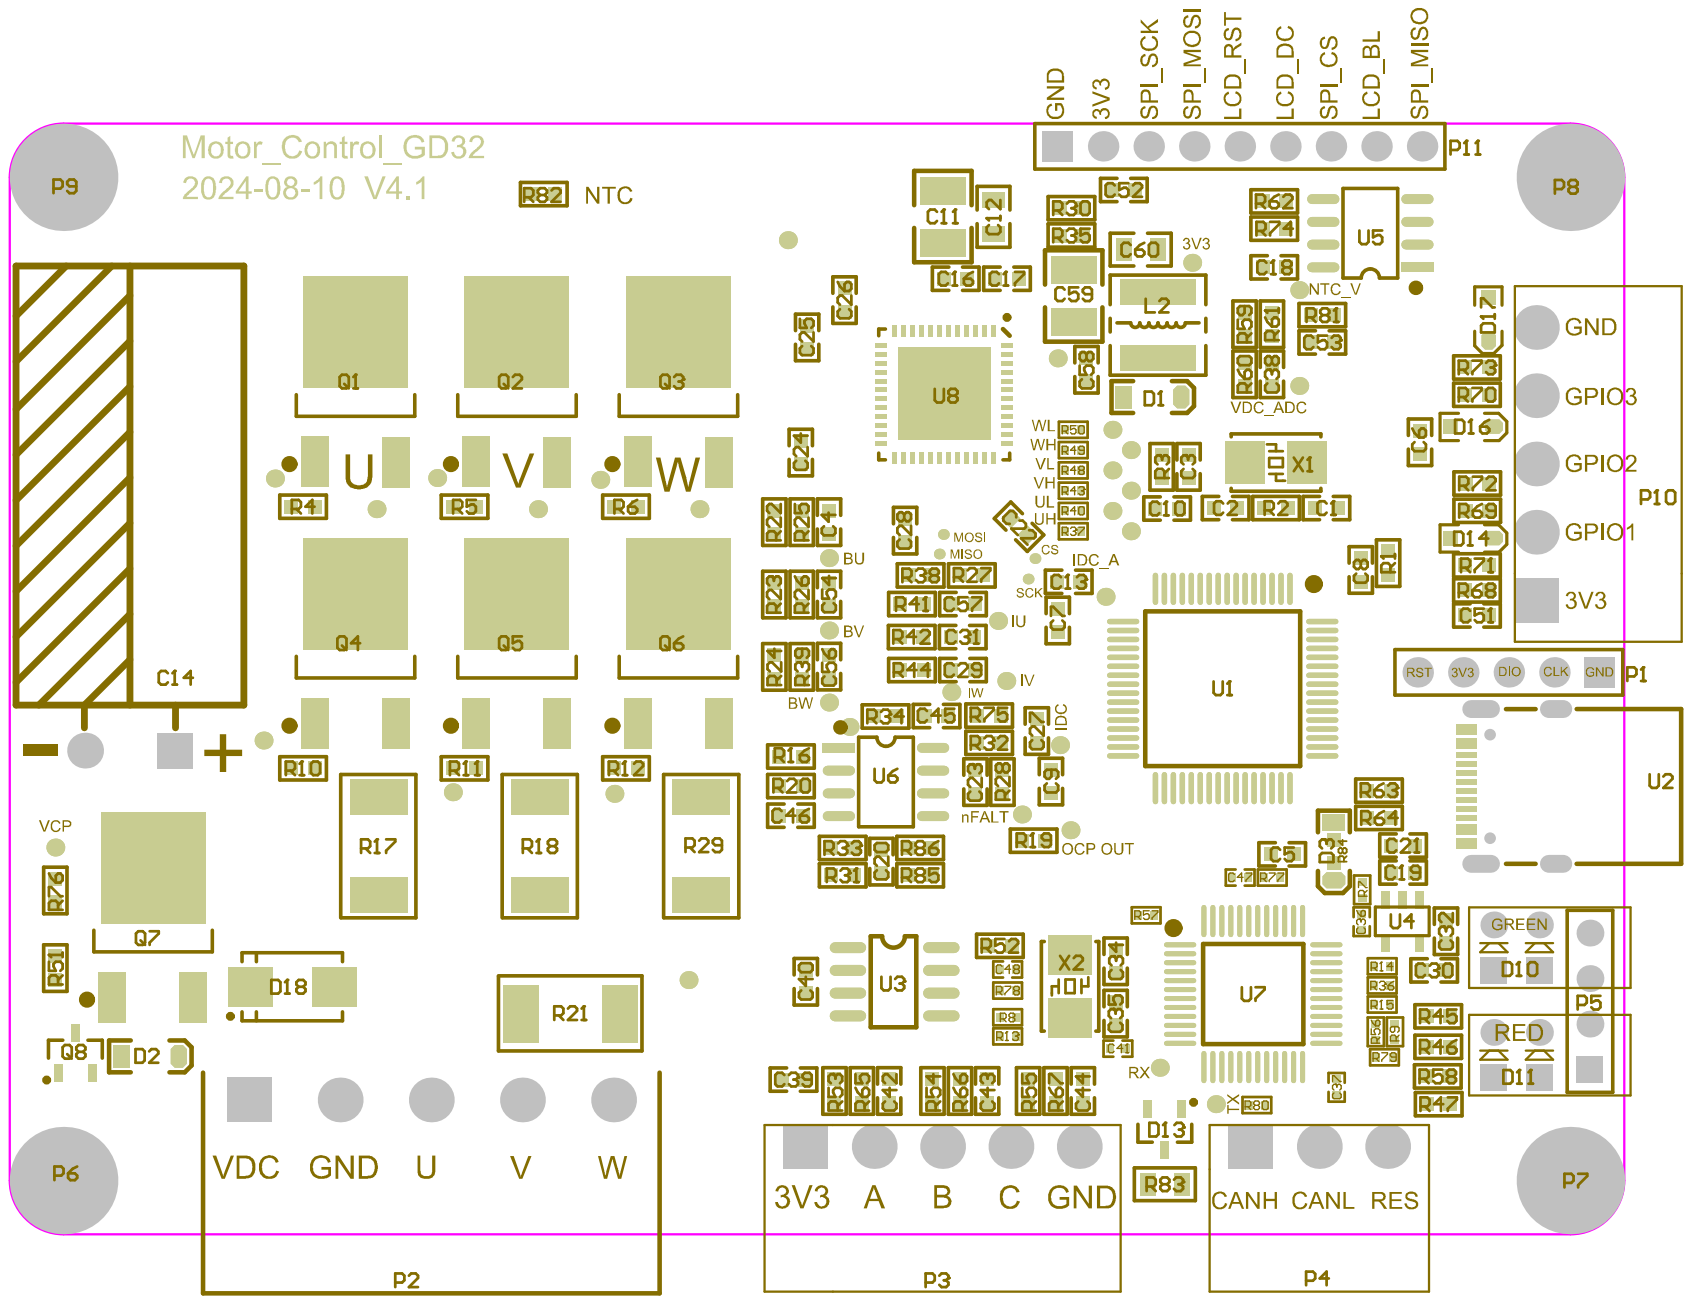
[picture p83: page 1]
