mzy2364/MC_GD32/Software/Application/09_MT6701/User/main.c

/*
*******************************************************************************************************
*
* File Name : main.c
* Version   : V1.0
* Author    : mzy2364
* brief     : main function file
* 
*******************************************************************************************************
*/


/* INCLUDE FILES ------------------------------------------------------------------------------------*/
#include <string.h>
#include "gd32f30x.h"
#include "gd32f30x_libopt.h"
#include "systick.h"
#include "led.h"
#include "motor_hardware.h"
#include "uart.h"
#include "i2c.h"
#include "eeprom.h"
#include "delay.h"
#include "adc_simple.h"
#include "lcd.h"
#include "lcd_init.h"
#include "can.h"
#include "encoder.h"
#include "drv8323rs.h"
#include "mt6701.h"
#include "task.h"
#include "motor_app.h"
#include "foc.h"
#include "pmsm.h"
#include "userparms.h"

/* DEFINES ------------------------------------------------------------------------------------------*/
#define START_DELAY_SEC     (float)2
#define START_DELAY_TICK    (uint32_t)((float)START_DELAY_SEC/(1/(float)MOTOR_PWM_FREQ_HZ))
    
#define PHASE_SHIFT_ANGLE (float)       (45.0f/180.0f*ANGLE_2PI)

/* VARIABLES ----------------------------------------------------------------------------------------*/
uint8_t adc_calibration = 0;
uint32_t ia_offset = 0,ib_offset = 0,ic_offset = 0,idc_offset = 0;
uint16_t adc1_ia = 0,adc1_ib = 0,adc1_ic = 0,adc1_idc = 0;

uint32_t start_delay_tick = 0;

float delta_angle = 0;
float angle_last = 0;
float angle_init = 0;
float angle = 0;
float mt6701_speed = 0;
uint16_t angle_u16 = 0;

uint16_t speed_filter_count = 0;
float speed_buf[10] = {0};
float speed_sum = 0;

float sensor_angle_offset = 0;

/* FUNCTION -----------------------------------------------------------------------------------------*/


/**
  * @brief main function
  * @param None
  * @retval None
  */
int main(void)
{
    SCB->VTOR = FLASH_BASE | 0x4000;
    __enable_irq();
    
    systick_init();
    led_init();
    usart_init();
    adc1_init();
    can_bus_init();
    encoder_init();
    DRV8323RS_init();
    mt6701_init();

    task_init();

    motor_hardware_init();
    pmsm_foc_param.pwm_period = (float)MOTOR_PWM_PERIOD * 0.96f;
    pmsm_foc_init();
    
    while(1)
    {
        task_scheduler();
    }
}

void TIMER0_BRK_IRQHandler(void)
{
    timer_channel_output_mode_config(TIMER0,TIMER_CH_0,TIMER_OC_MODE_INACTIVE);
    timer_channel_output_mode_config(TIMER0,TIMER_CH_1,TIMER_OC_MODE_INACTIVE);
    timer_channel_output_mode_config(TIMER0,TIMER_CH_2,TIMER_OC_MODE_INACTIVE);
    /* clear TIMER interrupt flag */
    timer_interrupt_flag_clear(TIMER0,TIMER_INT_FLAG_BRK);
    
    led_on(LED_FAULT);
}

void ADC0_1_IRQHandler(void)
{
    float temp1 = 0;
    float temp2 = 0;
    float temp3 = 0;
    uint8_t uart_data[16] = {0};
    uint16_t i = 0;
    
    /* clear the ADC flag */
    adc_interrupt_flag_clear(ADC0, ADC_INT_FLAG_EOIC);
    motor_app_isr();
}

/*!
    \brief      this function handles TIMER2 interrupt request.
    \param[in]  none
    \param[out] none
    \retval     none
*/
void TIMER2_IRQHandler(void)
{
    /* hall_speed = 2PI / (6 * delta_t) */
    /* delta_t = hall_timer_counter / timer_clk */
    if(SET == timer_interrupt_flag_get(TIMER2,TIMER_INT_FLAG_CH0))
    {
        /* clear channel 0 interrupt bit */
        timer_interrupt_flag_clear(TIMER2,TIMER_INT_FLAG_CH0);
    }
}

/***************************************** (END OF FILE) *********************************************/
