mzy2364/MC_GD32/Software/Application/11_FreeRTOS/01_FreeRTOS/FOC/userparms.h

/**
*   @file           userparms.h
*   @implements     userparms.h_Artifact
*   @version        v1.0.0
*   @date           2023-12-03
*   @author         mzy2364
*
*   @brief          Motor control user parameter definition
*   @details        
*
*   @addtogroup     PMSM Motor Control
*   @log
*       data        author            notes
*   2023-12-03      mzy2364           Create
*/

#ifndef _USERPARMS_H
#define _USERPARMS_H

#ifdef __cplusplus
extern "C"{
#endif

/*==================================================================================================
*                                        INCLUDE FILES
* 1) system and project includes
* 2) needed interfaces from external units
* 3) internal and external interfaces from this unit
==================================================================================================*/
#include <stdint.h>
#include "motor_config.h"
/*==================================================================================================
*                                      DEFINES AND MACROS
==================================================================================================*/
/*************** General Parameters ********************************************/
#define RPM_TO_RADS                                     ((float)2*M_PI/60)

/*************** Motor Parameters *********************************************/
//24V
//#define MOTOR_PHASE_RESISTANCE                          ((float)0.2)
//#define MOTOR_PHASE_INDUCTANCE                          ((float)0.000445f)
//#define MOTOR_PHASE_INDUCTANCE_DIV_2_PI                 ((float)(MOTOR_PHASE_INDUCTANCE/(2*M_PI)))	
//#define MOTOR_BACK_EMF_Vpeak                            (float)2.4
//#define MOTOR_NOPOLESPAIRS                               2

//12V
//#define MOTOR_PHASE_RESISTANCE                          ((float)0.065f)			// Resistance in Ohms 相电阻
//#define MOTOR_PHASE_INDUCTANCE                          ((float)0.000113f)		// Inductance in Henrys	 相电感
//#define MOTOR_PHASE_INDUCTANCE_DIV_2_PI                 ((float)(MOTOR_PHASE_INDUCTANCE/(2*M_PI)))	
//#define MOTOR_BACK_EMF_Vpeak                            (float)1.2               //反电动势
//#define MOTOR_NOPOLESPAIRS                               2

//57BL
//#define MOTOR_PHASE_RESISTANCE                          ((float)0.42)
//#define MOTOR_PHASE_INDUCTANCE                          ((float)0.00112)
//#define MOTOR_PHASE_INDUCTANCE_DIV_2_PI                 ((float)(MOTOR_PHASE_INDUCTANCE/(2*M_PI)))	
//#define MOTOR_BACK_EMF_Vpeak                            (float)4.27
//#define MOTOR_NOPOLESPAIRS                               2


//60V DC
#define MOTOR_PHASE_RESISTANCE                          ((float)0.6)
#define MOTOR_PHASE_INDUCTANCE                          ((float)0.000242)
#define MOTOR_PHASE_INDUCTANCE_DIV_2_PI                 ((float)(MOTOR_PHASE_INDUCTANCE/(2*M_PI)))	
#define MOTOR_BACK_EMF_Vpeak                            (float)1.24
#define MOTOR_NOPOLESPAIRS                               2

//105V DC
//#define MOTOR_PHASE_RESISTANCE                          ((float)6.97)
//#define MOTOR_PHASE_INDUCTANCE                          ((float)0.00535)
//#define MOTOR_PHASE_INDUCTANCE_DIV_2_PI                 ((float)(MOTOR_PHASE_INDUCTANCE/(2*M_PI)))	
//#define MOTOR_BACK_EMF_Vpeak                            (float)12.25
//#define MOTOR_NOPOLESPAIRS                               2

//25.2V 500W
//#define MOTOR_PHASE_RESISTANCE                          ((float)0.15)
//#define MOTOR_PHASE_INDUCTANCE                          ((float)0.000100)
//#define MOTOR_NOPOLESPAIRS                               2

//2808
//#define MOTOR_PHASE_RESISTANCE                          ((float)0.6)
//#define MOTOR_PHASE_INDUCTANCE                          ((float)0.000242)
//#define MOTOR_NOPOLESPAIRS                               7

//ZSDN-390-2-1
//#define MOTOR_PHASE_RESISTANCE                          ((float)0.0246)
//#define MOTOR_PHASE_INDUCTANCE                          ((float)0.00000641)
//#define MOTOR_NOPOLESPAIRS                               2


/*************** PWM and Control Timing Parameters ****************************/
#define PWMFREQUENCY_HZ                                 (float)MOTOR_PWM_FREQ_HZ
#define LOOPTIME_SEC                                    (float)(1/PWMFREQUENCY_HZ)

/*************** Startup Parameters *******************************************/
#define OPEN_LOOP_CURRENT                               2

#define SPEED_LOOP_CYCLE                                10

#define LOCK_TIME_SEC  		                            1
#define LOCK_COUNTER                                    (unsigned int)((float)LOCK_TIME_SEC/(float)LOOPTIME_SEC)

#define OPENLOOPTIMEINSEC 	                            1
#define OPEN_LOOP_END_SPEED_RPM                         1000

#define END_SPEED_RADS_MECH                             (float)(OPEN_LOOP_END_SPEED_RPM*RPM_TO_RADS)
#define END_SPEED_RADS_ELEC                             (float)(END_SPEED_RADS_MECH*MOTOR_NOPOLESPAIRS)
#define END_SPEED_RADS_ELEC_COUNTER                     (float)(END_SPEED_RADS_ELEC * LOOPTIME_SEC)
#define OPENLOOP_RAMPSPEED_INCREASERATE                 (float)(END_SPEED_RADS_ELEC_COUNTER/(OPENLOOPTIMEINSEC/LOOPTIME_SEC))
    
#define CL_RAMP_RATE_RPM_SEC                             3000 // CLosed Loop Speed Ramp rate in Rev/min/Sec
#define CL_RAMP_RATE_RPS_SEC                             ((float)CL_RAMP_RATE_RPM_SEC/60) // CLosed Loop  Speed Ramp rate in Rev/sec^2 
#define CL_RAMP_RATE_RADS_PER_SEC2_MECH                  (float)(CL_RAMP_RATE_RPS_SEC*2*M_PI) // CLosed Loop  Speed Ramp Rate in Mechanical Radians/Sec^2
#define CL_RAMP_RATE_RADS_PER_SEC2_ELEC                  (float)(CL_RAMP_RATE_RADS_PER_SEC2_MECH*MOTOR_NOPOLESPAIRS) // CLosed Loop  Speed Ramp rate in Electrical Radians/Sec^2
#define CL_SPEED_RAMP_RATE_DELTA                         (float)(CL_RAMP_RATE_RADS_PER_SEC2_ELEC*LOOPTIME_SEC) // CLosed Loop  Speed Ramp Rate in Electrical Radians/sec^2 in each control loop time
#define CL_SPEED_HYSTERESIS                              (float)(5*CL_SPEED_RAMP_RATE_DELTA)
    
#define NOMINAL_SPEED_RPM                                (float)3000 // Value in RPM
#define NOMINAL_SPEED_RAD_PER_SEC_ELEC                   (float)(((NOMINAL_SPEED_RPM/60)*2*M_PI)*MOTOR_NOPOLESPAIRS) // Value in RPM

/*************** PLL Parameters ***********************************************/
#define     MOTOR_BACK_EMF_CONSTANT_Vpeak_PHASE_RPM_MECH        (float)((MOTOR_BACK_EMF_Vpeak/1.732f)/1000)
#define     MOTOR_BACK_EMF_CONSTANT_Vpeak_PHASE_RPS_MECH        (float)(MOTOR_BACK_EMF_CONSTANT_Vpeak_PHASE_RPM_MECH * 60)
#define     MOTOR_BACK_EMF_CONSTANT_Vpeak_PHASE_RAD_PER_SEC_MECH (float)(MOTOR_BACK_EMF_CONSTANT_Vpeak_PHASE_RPS_MECH/(2*M_PI))
#define     MOTOR_BACK_EMF_CONSTANT_Vpeak_PHASE_RAD_PER_SEC_ELEC (float)(MOTOR_BACK_EMF_CONSTANT_Vpeak_PHASE_RAD_PER_SEC_MECH/MOTOR_NOPOLESPAIRS)
#define     INVKFi_BELOW_BASE_SPEED                               (float)(1/MOTOR_BACK_EMF_CONSTANT_Vpeak_PHASE_RAD_PER_SEC_ELEC)
    
#define     KFILTER_ESDQ                                        (float)((float)400/(float)32767)
#define     KFILTER_VELESTIM                                    (float)((float)(1*374)/(float)32767)


/*************** PID Parameters ***********************************************/

//******** D Control Loop Coefficients *******
#define     DKP        (0.02)
#define     DKI        (0.0002)
#define     DKC        (0.5)
#define     DOUTMAX    (0.99999)

//******** Q Control Loop Coefficients *******
#define     QKP        (0.02)
#define     QKI        (0.0002)
#define     QKC        (0.5)
#define     QOUTMAX    (0.99999)

//*** Velocity Control Loop Coefficients *****
#define     WKP        (0.01)
#define     WKI        (0.000001)
#define     WKC        (0.999)
#define     WOUTMAX    (10)


//#define OPEN_LOOP_MODE
//#define OPEN_LOOP_VF_VQ     0.2f
//#define TORQUE_MODE

#ifdef __cplusplus
}
#endif

#endif /* _USERPARMS_H */

/************************************************EOF************************************************/
