mzy2364/MC_GD32/Software/Application/10_lvgl/04_lvgl_foc/User/main.c

/*
*******************************************************************************************************
*
* File Name : main.c
* Version   : V1.0
* Author    : mzy2364
* brief     : main function file
* 
*******************************************************************************************************
*/


/* INCLUDE FILES ------------------------------------------------------------------------------------*/
#include <string.h>
#include "gd32f30x.h"
#include "gd32f30x_libopt.h"
#include "systick.h"
#include "led.h"
#include "motor_hardware.h"
#include "uart.h"
#include "i2c.h"
#include "eeprom.h"
#include "encoder.h"
#include "delay.h"
#include "adc_simple.h"
#include "lcd.h"
#include "lcd_init.h"
#include "can.h"
#include "drv8323rs.h"
#include "delay.h"
#include "eeprom.h"
#include "foc.h"
#include "pmsm.h"
#include "userparms.h"
#include "task.h"
#include "motor_app.h"

/* DEFINES ------------------------------------------------------------------------------------------*/

/* VARIABLES ----------------------------------------------------------------------------------------*/
uint32_t hall_timer_counter = 0;

float hall_theta_tab[6] = {0,PI*2/3,PI/3,PI*4/3,PI*5/3,PI};

/* FUNCTION -----------------------------------------------------------------------------------------*/

/**
  * @brief main function
  * @param None
  * @retval None
  */
int main(void)
{
    SCB->VTOR = FLASH_BASE | 0x4000;
    __enable_irq();
    
    systick_init();
    delay_tim_init();
    led_init();
    usart_init();
    adc1_init();
    i2c_init();
    can_bus_init();
    encoder_init();
    LCD_Init();
    LCD_Fill(0,0,LCD_W,LCD_H,BLACK);
    DRV8323RS_init();
    task_init();
    
    motor_hardware_init();
    pmsm_foc_param.pwm_period = MOTOR_PWM_PERIOD;
    pmsm_foc_init();
    
    while(1)
    {
        task_scheduler();
    }
}

void TIMER0_BRK_IRQHandler(void)
{
    timer_channel_output_mode_config(TIMER0,TIMER_CH_0,TIMER_OC_MODE_INACTIVE);
    timer_channel_output_mode_config(TIMER0,TIMER_CH_1,TIMER_OC_MODE_INACTIVE);
    timer_channel_output_mode_config(TIMER0,TIMER_CH_2,TIMER_OC_MODE_INACTIVE);
    /* clear TIMER interrupt flag */
    timer_interrupt_flag_clear(TIMER0,TIMER_INT_FLAG_BRK);
    motor_forced_stop();
    led_on(LED_FAULT);
}

void ADC0_1_IRQHandler(void)
{
    /* clear the ADC flag */
    adc_interrupt_flag_clear(ADC0, ADC_INT_FLAG_EOIC);
    motor_app_isr();
}

/*!
    \brief      this function handles CAN0 RX0 exception
    \param[in]  none
    \param[out] none
    \retval     none
*/
void USBD_LP_CAN0_RX0_IRQHandler(void)
{
    can_receive_message_struct receive_message;
    /* check the receive message */
    can_message_receive(CAN0, CAN_FIFO0, &receive_message);
}

/*!
    \brief      this function handles TIMER2 interrupt request.
    \param[in]  none
    \param[out] none
    \retval     none
*/
void TIMER2_IRQHandler(void)
{
    /* hall_speed = 2PI / (6 * delta_t) */
    /* delta_t = hall_timer_counter / timer_clk */
    if(SET == timer_interrupt_flag_get(TIMER2,TIMER_INT_FLAG_CH0))
    {
        /* clear channel 0 interrupt bit */
        timer_interrupt_flag_clear(TIMER2,TIMER_INT_FLAG_CH0);
        timer_interrupt_flag_clear(TIMER2,TIMER_INT_FLAG_UP);

        hall_timer_counter = timer_channel_capture_value_register_read(TIMER2,TIMER_CH_0)+1;
        pmsm_mc_param.hall_theta_inc = (PI/3)/((float)hall_timer_counter/HALL_TIMER_FREQ_HZ)/MOTOR_PWM_FREQ_HZ;
        motor1.hall_state = hall_get();
        if((motor1.hall_state > 0) && (motor1.hall_state <= 6))
        {
            motor1.rotor_lock_tick = 0;
            pmsm_mc_param.hall_theta = hall_theta_tab[motor1.hall_state - 1] + PHASE_SHIFT_ANGLE;
        }
        else
        {
            motor1.hall_state_fault = 1;
        }
    }
    else if(SET == timer_interrupt_flag_get(TIMER2,TIMER_INT_FLAG_UP))
    {
        timer_interrupt_flag_clear(TIMER2,TIMER_INT_FLAG_UP);

        pmsm_mc_param.hall_theta_inc = 0;
        motor1.hall_state = hall_get();
        if((motor1.hall_state > 0) && (motor1.hall_state <= 6))
        {
            pmsm_mc_param.hall_theta = hall_theta_tab[motor1.hall_state - 1] + PHASE_SHIFT_ANGLE;
        }
        else
        {
            motor1.hall_state_fault = 1;
        }
    }
}

/***************************************** (END OF FILE) *********************************************/
