mzy2364/MC_GD32/Software/Application/09_MT6701/User/Task/motor_app.h

/*
*******************************************************************************************************
*
* File Name : motor_app.h
* Version   : V1.0
* Author    : mzy2364
* brief     : motor control main file
* 
*******************************************************************************************************
*/
#ifndef _MOTOR_APP_H_
#define _MOTOR_APP_H_

#ifdef __cplusplus
extern "C"{
#endif

/* INCLUDE FILES ------------------------------------------------------------------------------------*/
#include "motor_hardware.h"
#include "motor_config.h"

/* DEFINES ------------------------------------------------------------------------------------------*/
#define START_DELAY_SEC             (float)2
#define START_DELAY_TICK            (uint32_t)((float)START_DELAY_SEC/(1/(float)MOTOR_PWM_FREQ_HZ))

#define ADC_CAL_COUNT               1024

#define OFFSET_ANGLE_CAL_COUNT          16000
#define OFFSET_ANGLE_CAL_DELAY_SEC      (float)3
#define OFFSET_ANGLE_CAL_DELAY_TICK     (uint32_t)((float)OFFSET_ANGLE_CAL_DELAY_SEC/(1/(float)MOTOR_PWM_FREQ_HZ))
    
#define SENSOR_DIR_POS              0
#define SENSOR_DIR_REV              1

typedef enum{
    INIT = 0,
    ADC_CAL,
    START_DELAY,
    STOP,
    SENSOR_OFFSET_CAL,
    RUN,
    FAULT,
}motor_state_t;

typedef enum{
    WAIT_STABLE = 0,        /* 等待开环运行稳定 */
    DIR_CAL,                /* 方向标定 */
    POLES_CAL,              /* 极对数标定 */
    OFFSET_CAL,             /* 偏移角标定 */
    CAL_DONE,               /* 标定结束 */
    CAL_ERROR,
}sensor_cal_state_t;

typedef struct{
    uint16_t adc_ia;
    uint16_t adc_ib;
    uint16_t adc_ic;
    uint16_t ia_offset;
    uint16_t ib_offset;
    uint16_t ic_offset;
    uint32_t adc_cal_cnt;
    
    uint32_t start_delay_tick;
    
    uint16_t ntc_adc;
    uint16_t vdc_adc;
    uint16_t idc_adc;
    float mosfet_temp;
    float vdc;
    float idc;
    
    uint16_t speed_rpm;
    
    uint8_t start;
    
    motor_state_t state;
    sensor_cal_state_t sensor_cal_state;
}motor_control_t;

/* VARIABLES ----------------------------------------------------------------------------------------*/


/* FUNCTION -----------------------------------------------------------------------------------------*/
void motor_app_init(void);
void motor_app_isr(void);
void motor_app_task10ms(void);
void motor_app_task100ms(void);
void motor_app_task500ms(void);
void motor_app_task1s(void);
void motor_app_idle(void);

#ifdef __cplusplus
extern "C"{
#endif

#endif /* _MOTOR_APP_H_ */

/***************************************** (END OF FILE) *********************************************/
