mzy2364/MC_GD32/Software/Application/10_lvgl/04_lvgl_foc/LCD/image.h

const unsigned char gImage_image[53248] = { /* 0X10,0X10,0X00,0XD0,0X00,0X80,0X01,0X1B, */
0XFF,0XFF,0XFF,0XFF,0XFF,0XFF,0XFF,0XFF,0XFF,0XFF,0XFF,0XFF,0XFF,0XFF,0XFF,0XFF,
0XFF,0XFF,0XFF,0XFF,0XFF,0XFF,0XFF,0XFF,0XFF,0XFF,0XFF,0XFF,0XFF,0XFF,0XFF,0XFF,
0XFF,0XFF,0XFF,0XFF,0XFF,0XFF,0XFF,0XFF,0XFF,0XFF,0XFF,0XFF,0XFF,0XFF,0XFF,0XFF,
0XFF,0XFF,0XFF,0XFF,0XFF,0XFF,0XFF,0XFF,0XFF,0XFF,0XFF,0XFF,0XFF,0XFF,0XFF,0XFF,
0XFF,0XFF,0XFF,0XFF,0XFF,0XFF,0XE7,0X7D,0X2B,0X90,0X0B,0X70,0X0B,0X70,0X0B,0X70,
0X0B,0X70,0X0B,0X70,0X0B,0X70,0X0B,0X70,0X0B,0X70,0X0B,0X70,0X0B,0X70,0X0B,0X70,
0X0B,0X70,0X0B,0X70,0X0B,0X70,0X0B,0X70,0X0B,0X70,0X0B,0X70,0X0B,0X70,0X0B,0X70,
0X0B,0X70,0X0B,0X70,0X0B,0X70,0X0B,0X70,0X0B,0X70,0X0B,0X70,0X0B,0X70,0X0B,0X70,
0X0B,0X70,0X0B,0X70,0X0B,0X70,0X0B,0X50,0X74,0XD4,0XFF,0XFF,0XFF,0XFF,0XFF,0XFF,
0XFF,0XFF,0XFF,0XFF,0XFF,0XFF,0XFF,0XFF,0XFF,0XFF,0XFF,0XFF,0XFF,0XFF,0XFF,0XFF,
0XFF,0XFF,0XFF,0XFF,0XFF,0XFF,0XFF,0XFF,0XFF,0XFF,0XFF,0XFF,0XFF,0XFF,0XFF,0XFF,
0XFF,0XFF,0XFF,0XFF,0XFF,0XFF,0XFF,0XFF,0XFF,0XFF,0XFF,0XFF,0XFF,0XFF,0XFF,0XFF,
0XFF,0XFF,0XFF,0XFF,0XFF,0XFF,0XFF,0XFF,0XFF,0XFF,0XFF,0XFF,0XFF,0XFF,0XFF,0XFF,
0XFF,0XFF,0XFF,0XFF,0XFF,0XFF,0XFF,0XFF,0XFF,0XFF,0XFF,0XFF,0XFF,0XFF,0XFF,0XFF,
0XFF,0XFF,0XFF,0XFF,0XFF,0XFF,0XFF,0XFF,0XFF,0XFF,0XFF,0XFF,0XFF,0XFF,0XFF,0XFF,
0XFF,0XFF,0XFF,0XFF,0XFF,0XFF,0XFF,0XFF,0XFF,0XFF,0XFF,0XFF,0XFF,0XFF,0XFF,0XFF,
0XFF,0XFF,0XFF,0XFF,0XFF,0XFF,0XFF,0XFF,0XFF,0XFF,0XFF,0XFF,0XFF,0XFF,0XFF,0XFF,
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
0X02,0XCF,0X02,0XCF,0X02,0XCF,0X02,0XCF,0X02,0XCF,0X02,0XCF,0X02,0XCF,0X02,0XCF,
0X02,0XCF,0X02,0XCF,0X02,0XCF,0X02,0XCF,0X02,0XCF,0X02,0XCF,0X02,0XCF,0X02,0XCF,
0X02,0XCF,0X02,0XCF,0X02,0XCF,0X02,0XCF,0X02,0XCF,0X02,0XCF,0X0B,0X0F,0X0B,0X70,
0X0B,0X70,0X0B,0X70,0X0B,0X70,0X0B,0X70,0X46,0X1B,0X46,0X1B,0X46,0X1B,0X46,0X1B,
0X46,0X1B,0X46,0X1B,0X46,0X1B,0X46,0X1B,0X46,0X1B,0X46,0X1B,0X46,0X1B,0X46,0X1B,
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
