mzy2364/MC_GD32/(commit log)

2024-10-20 add document and application
    [霍尔计算转速.xlsx]
2024-11-21 修复VF例程电流通道的笔误，增加PCB位号图，增加通过排针烧录程序的方法
2025-03-17 add lvgl demo
    [霍尔计算转速.xlsx]
2025-04-17 add pwm_capture example
2025-06-08 add lvgl_foc application demo
    [EEPROM参数列表.xlsx]
2025-07-07 使用前必读新增编码器使用说明,优化lvgl_foc程序
    [EEPROM参数列表.xlsx]
2025-07-08 编码器方向反转
2025-07-09 修复变量计算错误的BUG,修改默认参数
2025-08-03 更新数据刷新频率,增加霍尔状态显示功能
2025-10-25 增加RS485通讯例程
2025-11-27 增加V4.2硬件的原理图和位号图
2025-11-29 优化MT6701例程,增加初始角度标定功能
2025-12-06 增加MT6701例程的传感器方向和极对数标定
2025-12-07 增加MT6701的方向标定次数防止标定失败
